JasonFJ9/BachelorThesisPCBs/README.md

# BachelorThesisPCBs
PCBs from Bachelor Thesis
