JasonFJ9/BachelorThesisPCBs/SolarEnergyManager_v1.0/SolarEnergyManager_v1.0_BOM.xlsx

Item | Qty | Reference(s) | Value | Footprint | Manufacturer_Part_Number | Mouser Part Number | Mouser Link
x | 0 | AH0, AH1, AH2 | JP | Jumper:SolderJumper-2_P1.3mm_Open_TrianglePad1.0x1.5mm
1 | 2 | C201, C202 | 15pF High Freq | Capacitor_SMD:C_0402_1005Metric | CBR04C150J5GACAUTO | 80-CBR04C150J5GAUTO | https://www.mouser.de/ProductDetail/KEMET/CBR04C150J5GACAUTO?qs=By6Nw2ByBD0gttAEYK%2FPlg%3D%3D
2 | 16 | C203, C204, C205, C206, C207, C208, C211, C212, C213, C215, C302, C304, C401, C403, C404, C406 | 0.1uF | Capacitor_SMD:C_0402_1005Metric | 0402X7R104KT7AT | 581-0402X7R104KT7AT | https://www.mouser.de/ProductDetail/KYOCERA-AVX/0402X7R104KT7AT?qs=DPoM0jnrROXD467pFR2ukA%3D%3D
3 | 6 | C209, C210, C501, C502, C503, C504 | 1uF | Capacitor_SMD:C_0402_1005Metric | MBASL105SB5105KFNA01 | 963-BASL105SB5105KF | https://www.mouser.de/ProductDetail/TAIYO-YUDEN/MBASL105SB5105KFNA01?qs=tlsG%2FOw5FFjuFnjILgo9OQ%3D%3D
4 | 3 | C214, C301, C303 | 4.7uF | Capacitor_SMD:C_0402_1005Metric | GRT155C81A475ME13D | 81-GRT155C81A475ME3D | https://www.mouser.de/ProductDetail/Murata-Electronics/GRT155C81A475ME13D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
5 | 2 | C402, C405 | 10uF | Capacitor_SMD:C_0402_1005Metric | GRT155R60J106ME13J | 81-GRT155R60J106ME13 | https://www.mouser.de/ProductDetail/Murata-Electronics/GRT155R60J106ME13J?qs=xZFQr2mActfRufp7i60hKA%3D%3D
x | 0 | C_Load1, J_RST1, J_RST2, P26, P30, PrbA1, PrbA2, PrbA3, PrbA_AEM1, PrbV1, PrbV2, PrbV3, PrbV_AEM1, R_Load1, USB_SRC1 | 01x02_Pin | Connector_PinHeader_2.54mm:PinHeader_1x02_P2.54mm_Vertical
6 | 2 | CBATT1, CLP5 | 220uF | Capacitor_SMD:C_1206_3216Metric | GRM31CR60J227ME11K | 81-GRM31CR60J227ME1K | https://www.mouser.de/ProductDetail/Murata-Electronics/GRM31CR60J227ME11K?qs=Ey7%2FXF42M3d4sLQcNXT7QA%3D%3D
7 | 1 | CBOOST1 | 22uF | Capacitor_SMD:C_0603_1608Metric | MSASJ168BB5226MTNA01 | 963-MSASJ168BB5226MT | https://www.mouser.de/ProductDetail/TAIYO-YUDEN/MSASJ168BB5226MTNA01?qs=tlsG%2FOw5FFg3tazonz3P5w%3D%3D
8 | 4 | CBUCK1, CHV1, CLV1, CSRC1 | 10uF | Capacitor_SMD:C_0603_1608Metric | MSASJ168AB5106KTNA01 | 963-MSASJ168AB5106KT | https://www.mouser.de/ProductDetail/TAIYO-YUDEN/MSASJ168AB5106KTNA01?qs=tlsG%2FOw5FFif5EhwKrunRA%3D%3D
9 | 1 | CLP0 | 1uF | Capacitor_SMD:C_1206_3216Metric | 12066C105KAT2A | 581-12066C105KAT2A | https://www.mouser.de/ProductDetail/KYOCERA-AVX/12066C105KAT2A?qs=gt1LBUVyoHm562E85hrgog%3D%3D
10 | 1 | CLP1 | 10uF | Capacitor_SMD:C_1206_3216Metric | 12066G106ZAT4A | 581-12066G106ZAT4A | https://www.mouser.de/ProductDetail/KYOCERA-AVX/12066G106ZAT4A?qs=f21FSZc47Pg9KHN6RDKhaQ%3D%3D
11 | 1 | CLP2 | 47uF | Capacitor_SMD:C_1206_3216Metric | JMK316ABJ476ML8T | 963-JMK316ABJ476ML8T | https://www.mouser.de/ProductDetail/TAIYO-YUDEN/JMK316ABJ476ML8T?qs=DPoM0jnrROULYJSu6x6JQQ%3D%3D
12 | 2 | CLP3, CLP4 | 100uF | Capacitor_SMD:C_1206_3216Metric | MSASJ31LAB5107MTNA01 | 963-MSASJ31LAB5107MT | https://www.mouser.de/ProductDetail/TAIYO-YUDEN/MSASJ31LAB5107MTNA01?qs=tlsG%2FOw5FFiNCooN9mmaqw%3D%3D
x | 0 | CLP4 | 150uF | Capacitor_SMD:C_1206_3216Metric | none | none
13 | 2 | D1, D501 | B5817W-TP | B5817W-TP:SOD3716X135N | B5817W-TP | 833-B5817W-TP | https://www.mouser.de/ProductDetail/Micro-Commercial-Components-MCC/B5817W-TP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
14 | 5 | D201, D202, D203, USB_LED1, VReg_LED1 | LED | LED_SMD:LED_0402_1005Metric | LB QH9G-N1OO-35-1 | 720-LBQH9G-N1P2-35-1 | https://www.mouser.de/ProductDetail/ams-OSRAM/LB-QH9G-N1OO-35-1?qs=74fRo9GAWsxCauYngFcKCA%3D%3D
x | 0 | H1, H2, H3, H4, Ha1, Ha2, Ha3, Ha4 | MountingHole_Pad | MountingHole:MountingHole_3.2mm_M3_Pad
15 | 1 | IC1 | AEM10941-QFN | AEM10941-QFN:QFN50P500X500X90-29N-D | AEM10941-QFN | 120-AEM10941-QFN | https://www.mouser.de/ProductDetail/e-peas/AEM10941-QFN?qs=W%2FMpXkg%252BdQ7CeqB2lBPbRQ%3D%3D
16 | 1 | IC201 | RP2040 | Package_DFN_QFN:QFN-56-1EP_7x7mm_P0.4mm_EP3.2x3.2mm | SC0914(13) | 358-SC091413 | https://www.mouser.de/ProductDetail/Raspberry-Pi/SC091413?qs=T%252BzbugeAwjhr%252BUbBr3TJcw%3D%3D
17 | 1 | IC202 | W25Q16JVUXIQ_TR | W25Q16JVUXIQ_TR:SON50P300X200X60-9N | W25Q16JVUXIQ TR | 454-W25Q16JVUXIQTR | https://www.mouser.de/ProductDetail/Winbond/W25Q16JVUXIQ-TR?qs=qSfuJ%252Bfl%2Fd7SDdIHLGOd1g%3D%3D
18 | 2 | IC301, IC302 | PAC1934T-I_JQ | PAC1934T-I_JQ:QFN65P400X400X55-17N-D | PAC1934T-I/JQ | 579-PAC1934JQ | https://www.mouser.de/ProductDetail/Microchip-Technology/PAC1934T-I-JQ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
19 | 1 | IC401 | VEML7700-TT | VEML7700-TT:VEML7700 | VEML7700-TT | 78-VEML7700-TT | https://www.mouser.de/ProductDetail/Vishay-Semiconductors/VEML7700-TT?qs=BcfjnG7NVaXdL6DJFdWbdw%3D%3D
20 | 1 | IC402 | TMP1075DSGR | TMP1075DSGR:SON50P200X200X80-9N | TMP1075DSGR | 595-TMP1075DSGR | https://www.mouser.de/ProductDetail/Texas-Instruments/TMP1075DSGR?qs=gZXFycFWdAOidBdJW42bRw%3D%3D
21 | 1 | IC403 | MCP23017-E_ML | MCP23017-E_ML:QFN65P600X600X100-29N-D | MCP23017-E/ML | 579-MCP23017-E/ML | https://www.mouser.de/ProductDetail/Microchip-Technology/MCP23017-E-ML?qs=usxtMOJb1RwOdfCNDE63wQ%3D%3D
22 | 2 | IC501, IC502 | AP2112K-3.3TRG1 | AP2112K-3.3TRG1:SOT95P282X130-5N | AP2112K-3.3TRG1 | 621-AP2112K-3.3TRG1 | https://www.mouser.de/ProductDetail/Diodes-Incorporated/AP2112K-3.3TRG1?qs=x6A8l6qLYDDPYHosCdzh%2FA%3D%3D
x | 0 | J201 | Conn_01x03_Pin | Connector_PinSocket_2.54mm:PinSocket_1x03_P2.54mm_Vertical
x | 0 | J202 | Conn_01x06_Pin | Connector_PinSocket_2.54mm:PinSocket_1x06_P2.54mm_Vertical
x | 0 | J203 | Conn_01x08_Pin | Connector_PinSocket_2.54mm:PinSocket_1x08_P2.54mm_Vertical
23 | 1 | J401 | MEM2052-00-195-00-A_REVA | MEM2052-00-195-00-A_REVA:GCT_MEM2052-00-195-00-A_REVA | MEM2052-00-195-00-A | 640-MEM20520019500A | https://www.mouser.de/ProductDetail/GCT/MEM2052-00-195-00-A?qs=Jm2GQyTW%2Fbh7Ze6LKWKWwA%3D%3D
24 | 1 | J501 | USB4105-GF-A | USB4105_GF_A:GCT_USB4105-GF-A | USB4105-GF-A | 640-USB4105-GF-A | https://www.mouser.de/ProductDetail/GCT/USB4105-GF-A?qs=KUoIvG%2F9IlY%2FMLlBMpStpA%3D%3D
x | 0 | J_AEM_OUT1, J_AEM_OUT2, LDO1, P_CFG0, P_CFG1, P_CFG2, P_ENHV1, P_ENLV1, P_SELMPP0, P_SELMPP1, VRegT1, VRegT2 | 01x03_Pin | Connector_PinHeader_2.54mm:PinHeader_1x03_P2.54mm_Vertical
x | 2 | J_BATT1, J_PRIM1 | S2B-PH-SM4-TB | S2B_PH_SM4_TB:CONN_S2B-PH-SM4-TB_JST
25 | 5 | J_BATT2, J_PRIM2, J_SC1, J_SC2, J_SRC1 | 691137710002 | 691137710002:CONN2_710002_WRE | 691137710002 | 710-691137710002 | https://www.mouser.de/ProductDetail/Wurth-Elektronik/691137710002?qs=lBTPRtX1sU9LnHBbviNKGA%3D%3D
26 | 1 | LBOOST1 | 10uH | Inductor_SMD:L_Vishay_IFSC-1515AH_4x4x1.8mm | LPS4018-103MRC | 994-LPS4018-103MRC | https://www.mouser.de/ProductDetail/Coilcraft/LPS4018-103MRC?qs=QQJxVsr8EGa4OX30WnhtBw%3D%3D
27 | 1 | LBUCK1 | 10uH | Inductor_SMD:L_0603_1608Metric | MLZ1608M100WTD25 | 810-MLZ1608M100WTD25 | https://www.mouser.de/ProductDetail/TDK/MLZ1608M100WTD25?qs=u4%252BEJ9urDATpNhOvJ54DAQ%3D%3D
28 | 3 | Q1, Q2, Q3 | BSS138 | BSS138:SOT95P240X120-3N | BSS138 | 512-BSS138 | https://www.mouser.de/ProductDetail/onsemi-Fairchild/BSS138?qs=HK%252BeIG1iaahCeqBvjB4arg%3D%3D
29 | 7 | Q6S12, Q601, Q602, Q603, Q604, Q605, Q606 | SI4204DY-T1-GE3 | SI4204DY-T1-GE3:SOIC127P600X175-8N | SI4204DY-T1-GE3 | 781-SI4204DY-T1-GE3 | https://www.mouser.de/ProductDetail/Vishay-Semiconductors/SI4204DY-T1-GE3?qs=WX95TUc1y56KMN7BzssOTA%3D%3D
x | 0 | R1, R4, R5, R6, R7, R8 | TBD | Resistor_SMD:R_0603_1608Metric
30 | 38 | R1L1, R1L2, R1L3, R1L4, R1L5, R1L6 R209, R210, R211, R212, R301, R302, R305, R306, R403, R404, R405, R406, R407, R408, R409, R503, R505, R607, R608, R609, R610, R611, R612, R619, R620, R621, R622, R623, R624 RsV1, RsV2, RsV3 | 10kR (35) nT; (3) 1% | Resistor_SMD:R_0402_1005Metric | RCC040210K0FKED | 71-RCC040210K0FKED | https://www.mouser.de/ProductDetail/Vishay-Dale/RCC040210K0FKED?qs=GedFDFLaBXEVoNpALwSuTw%3D%3D
31 | 6 | R2, R3, R25, R26, R29, R30 | 0R | Resistor_SMD:R_0603_1608Metric | RCC06030000Z0EA | 71-RCC06030000Z0EA | https://www.mouser.de/ProductDetail/Vishay-Dale/RCC06030000Z0EA?qs=GedFDFLaBXGafTcDIEa6hQ%3D%3D
32 | 2 | R27, R28 | 100R | Resistor_SMD:R_0603_1608Metric | SDR03EZPF1000 | 755-SDR03EZPF1000 | https://www.mouser.de/ProductDetail/ROHM-Semiconductor/SDR03EZPF1000?qs=byeeYqUIh0OpQ5v1HQWApg%3D%3D
33 | 2 | R201, R202 | 27R 1% HiP | Resistor_SMD:R_0402_1005Metric | CR0402-FX-27R0GLF | 652-CR0402FX-27R0GLF | https://www.mouser.de/ProductDetail/Bourns/CR0402-FX-27R0GLF?qs=SFHnMgm9IsxG%252BvpJZf0h2g%3D%3D
34 | 13 | R203, R601, R602, R603, R604, R605, R606, R613, R614, R615, R616, R617, R618 | 1kR | Resistor_SMD:R_0402_1005Metric | CRCW04021K00FKED | 71-CRCW0402-1.0K-E3 | https://www.mouser.de/ProductDetail/Vishay-Dale/CRCW04021K00FKED?qs=YX%252BK5oaHNYqQ2WK%252BIAW12A%3D%3D
35 | 5 | R204, R205, R206, R504, R506 | 1.5kR | Resistor_SMD:R_0402_1005Metric | CR0402-FX-1501GLF | 652-CR0402FX-1501GLF | https://www.mouser.de/ProductDetail/Bourns/CR0402-FX-1501GLF?qs=JflQ4L8so%2FsxQ5cqzjGcHQ%3D%3D
36 | 2 | R207, RA1 | 499R 1% | Resistor_SMD:R_0402_1005Metric | CR0402-FX-4990GLF | 652-CR0402FX-4990GLF | https://www.mouser.de/ProductDetail/Bourns/CR0402-FX-4990GLF?qs=ePR1ZvdkOKIzeZiWxp12Ig%3D%3D
37 | 1 | R208 | 2kR | Resistor_SMD:R_0402_1005Metric | 560112110064 | 710-560112110064 | https://www.mouser.de/ProductDetail/Wurth-Elektronik/560112110064?qs=mELouGlnn3ev5cD7nBIyFQ%3D%3D
38 | 3 | R213, R214, R402 | 4.7kR | Resistor_SMD:R_0402_1005Metric | 560112110245 | 710-560112110245 | https://www.mouser.de/ProductDetail/Wurth-Elektronik/560112110245?qs=mELouGlnn3eeBrSsGNQoSQ%3D%3D
39 | 5 | R303, R304, R307, R308, R401 | 0R | Resistor_SMD:R_0402_1005Metric | RCA04020000ZSED | 71-RCA04020000ZSED | https://www.mouser.de/ProductDetail/Vishay-Draloric/RCA04020000ZSED?qs=gk21WLQFtgRTmhk63km%2F1w%3D%3D
40 | 2 | R501, R502 | 5kR | Resistor_SMD:R_0402_1005Metric | RC0402FR-075KL | 603-RC0402FR-075KL | https://www.mouser.de/ProductDetail/YAGEO/RC0402FR-075KL?qs=9h0bZHM%2F3zL5adZvfm%252BR4Q%3D%3D
41 | 1 | RA2 | 806R 1% | Resistor_SMD:R_0402_1005Metric | CR0402-FX-8060GLF | 652-CR0402-FX8060GLF | https://www.mouser.de/ProductDetail/Bourns/CR0402-FX-8060GLF?qs=ePR1ZvdkOKKCsmL%252BFFkSoQ%3D%3D
42 | 1 | RLS0 | 1R 1% HiP | Resistor_SMD:R_0805_2012Metric | RCS08051R00FKEA | 71-RCS08051R00FKEA | https://www.mouser.de/ProductDetail/Vishay-Dale/RCS08051R00FKEA?qs=NKmfXavxMazIduhBo739WA%3D%3D
43 | 1 | RLS1 | 2.2R 1% HiP | Resistor_SMD:R_0805_2012Metric | CRCW08052R20FKEAHP | 71-CRCW08052R20FKEAH | https://www.mouser.de/ProductDetail/Vishay-Dale/CRCW08052R20FKEAHP?qs=40TFAHZMFvc8altFjF5kRw%3D%3D
44 | 1 | RLS2 | 4.7R 1% HiP | Resistor_SMD:R_0805_2012Metric | CRCW08054R70FKEAHP | 71-CRCW08054R70FKEAH | https://www.mouser.de/ProductDetail/Vishay-Dale/CRCW08054R70FKEAHP?qs=z98O12pCCDc%2FBP4iR2245Q%3D%3D
45 | 1 | RLS3 | 10R 1% HiP | Resistor_SMD:R_0805_2012Metric | CRCW080510R0FKEAHP | 71-CRCW080510R0FKEAH | https://www.mouser.de/ProductDetail/Vishay-Dale/CRCW080510R0FKEAHP?qs=k2%2FDWSARqgG82EOEfyX0fw%3D%3D
46 | 1 | RLS4 | 22R 1% HiP | Resistor_SMD:R_0805_2012Metric | RCS080522R0FKEA | 71-RCS080522R0FKEA | https://www.mouser.de/ProductDetail/Vishay-Dale/RCS080522R0FKEA?qs=HalnxurKHBtrICSsz48sGQ%3D%3D
47 | 1 | RLS5 | 33R 1% HiP | Resistor_SMD:R_0805_2012Metric | CRCW080533R0FKEAHP | 71-CRCW080533R0FKEAH | https://www.mouser.de/ProductDetail/Vishay-Dale/CRCW080533R0FKEAHP?qs=40TFAHZMFvf1kHsc18Wg6g%3D%3D
48 | 1 | RLS6 | 47R 1% HiP | Resistor_SMD:R_0805_2012Metric | CRCW080547R0FKEAHP | 71-CRCW080547R0FKEAH | https://www.mouser.de/ProductDetail/Vishay-Dale/CRCW080547R0FKEAHP?qs=YmE2lSBYOPn9tegEwszIow%3D%3D
49 | 5 | RsA1, RsA2, RsA3, RsA4, RsA5 | 0.5R 1% HiP | Resistor_SMD:R_0805_2012Metric | CSSH0805FTL500 | 708-CSSH0805FTL500 | https://www.mouser.de/ProductDetail/SEI-Stackpole/CSSH0805FTL500?qs=IPgv5n7u5QZm%252Br%252BnQCvBxw%3D%3D
50 | 3 | RVd1, RVd2, RVd3 | 150kR 1% | Resistor_SMD:R_0402_1005Metric | 560112110128 | 710-560112110128 | https://www.mouser.de/ProductDetail/Wurth-Elektronik/560112110128?qs=mELouGlnn3dmJAZZ6u3GOA%3D%3D
51 | 5 | S201, S202, S203, S204, S205 | TL3365AF180QG | TL3365AF180QG:TL3365AF180QG | TL3365AF180QG | 612-TL3365AF180QG | https://www.mouser.de/ProductDetail/E-Switch/TL3365AF180QG?qs=xQzBpF%2FAFTo%252BA4IL7l2Rvw%3D%3D
52 | 1 | SC1 | 47mF | Custom_Footprints_Lib:Capacitor_Radial_D12mm_P6.8mm | ADCM-S05R5SA473WB | 815-ADCMS05R5SA473WB | https://www.mouser.de/ProductDetail/ABRACON/ADCM-S05R5SA473WB?qs=HoCaDK9Nz5evZ626CffJaQ%3D%3D
x | 0 | SC_T_1 | Conn_02x02 | Connector_PinHeader_2.54mm:PinHeader_2x02_P2.54mm_Vertical
53 | 1 | Y201 | ABM8-272-T3 | ABM8-272-T3:ABM8272T3 | ABM8-272-T3 | 815-ABM8-272-T3 | https://www.mouser.de/ProductDetail/ABRACON/ABM8-272-T3?qs=QpmGXVUTftEj6miOiJBMxQ%3D%3D
