JasonFJ9/BachelorThesisPCBs/SolarCurveTracer_v1.1/SolarCurveTracer.kicad_pcb

## KiCad design SolarCurveTracer_v1.1/SolarCurveTracer.kicad_pcb (2024-07-26)

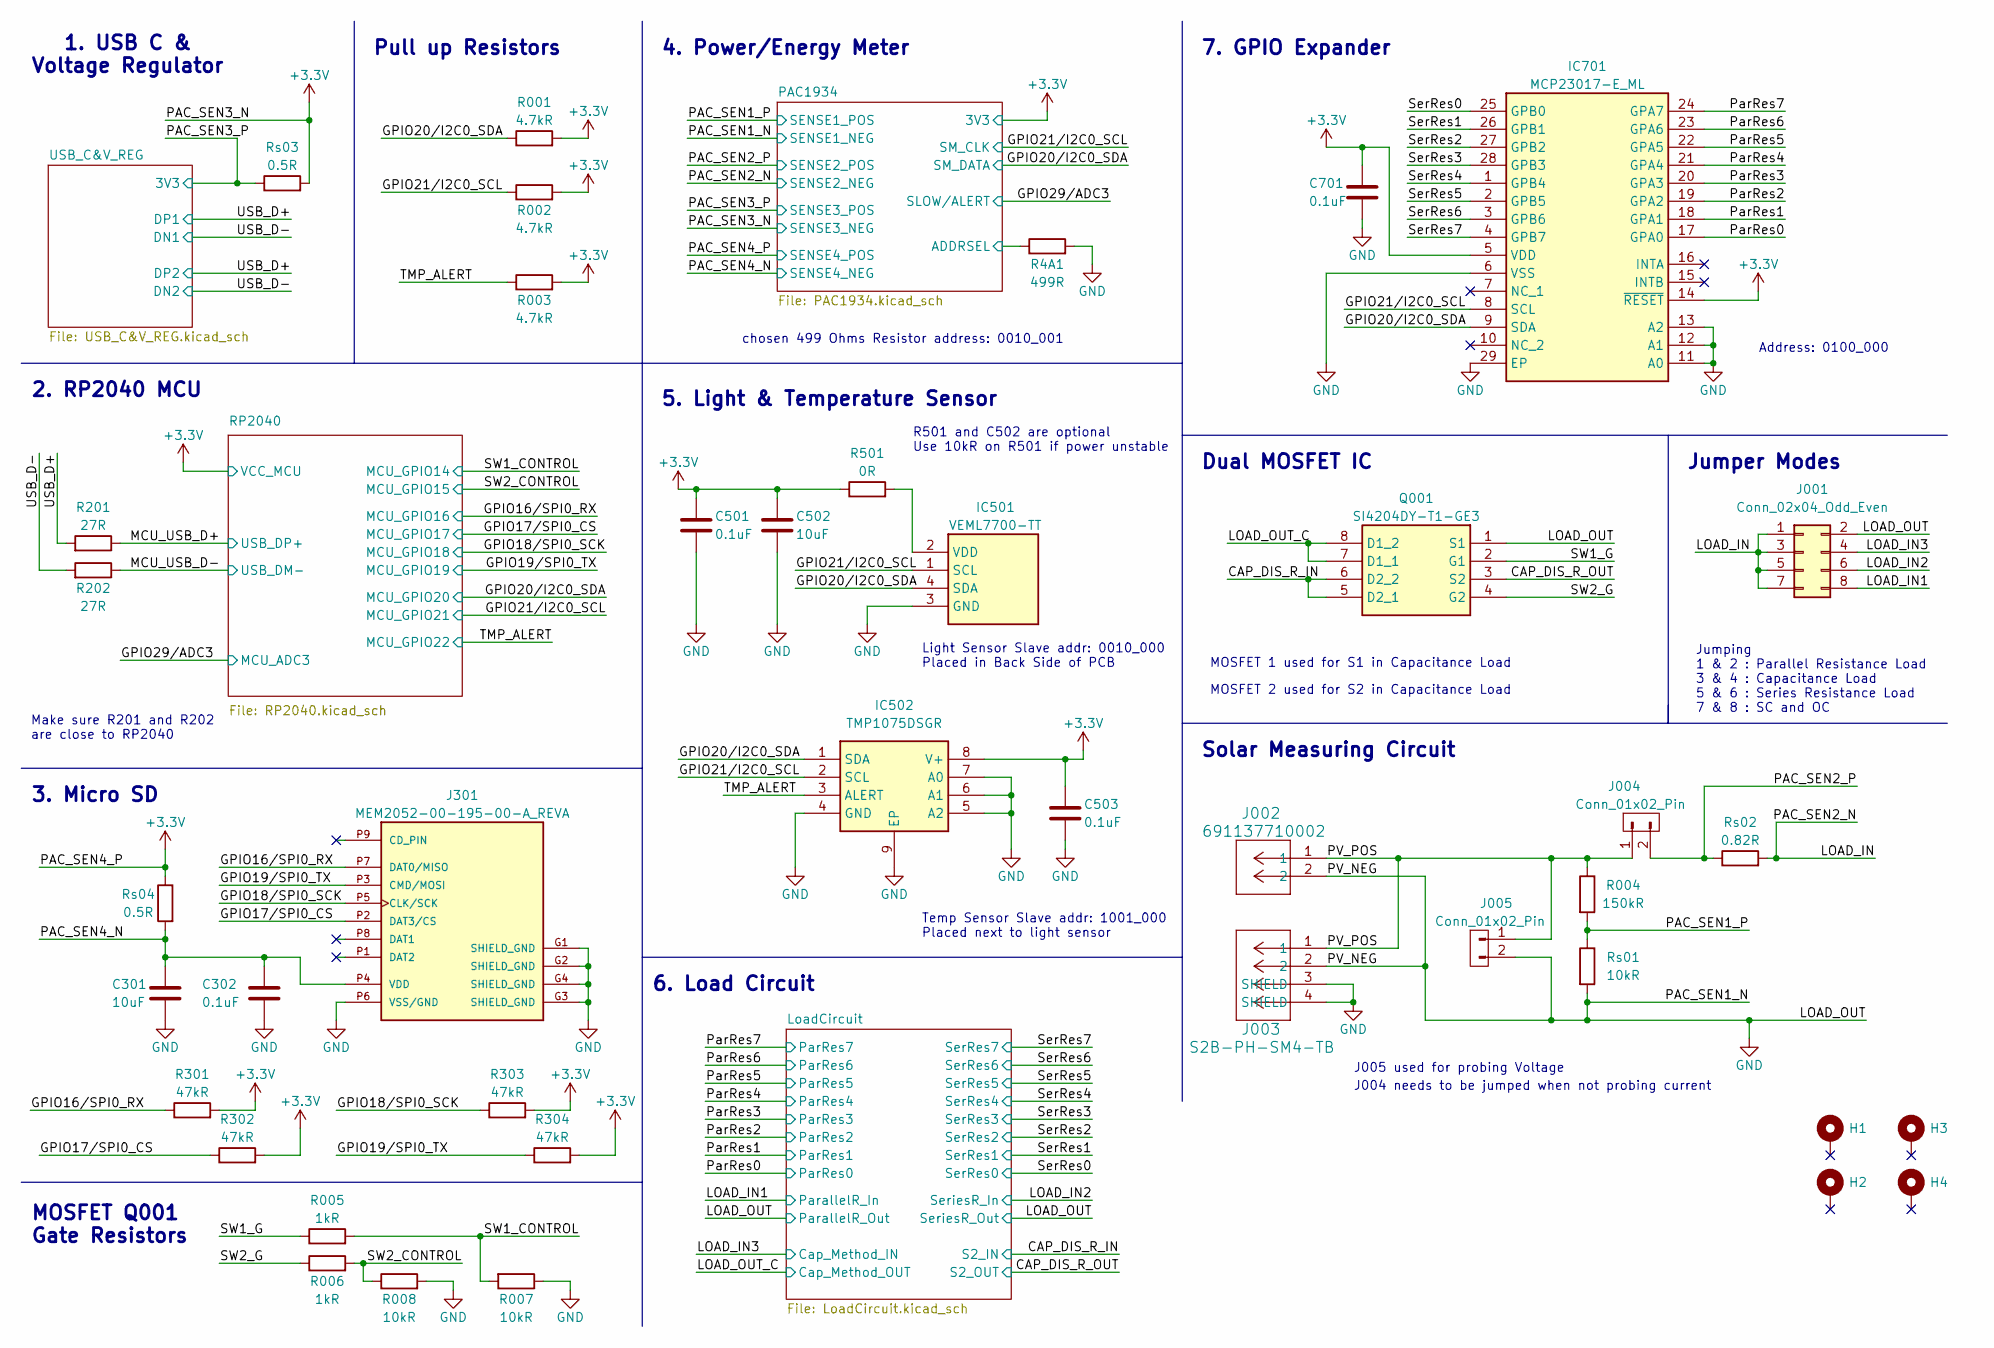
[picture p1: schematic SolarCurveTracer.kicad_sch, Solar Curve Tracer]

Parts:
C301, C502: 10uF; C_0603_1608Metric
C302, C501, C701: 0.1uF; C_0603_1608Metric
C503: 0.1uF; C_0402_1005Metric
H1, H2, H3, H4: MountingHole_Pad; MountingHole_3.2mm_M3_Pad
IC501: VEML7700-TT; VEML7700; Mouser Part Number 78-VEML7700-TT
IC502: TMP1075DSGR; SON50P200X200X80-9N; Mouser Part Number 595-TMP1075DSGR
IC701: MCP23017-E_ML; QFN65P600X600X100-29N-D; Mouser Part Number 579-MCP23017-E/ML
J001: Conn_02x04_Odd_Even; PinHeader_2x04_P2.54mm_Vertical
J002: 691137710002; CONN2_710002_WRE
J003: S2B-PH-SM4-TB; CONN_S2B-PH-SM4-TB_JST
J004, J005: Conn_01x02_Pin; PinHeader_1x02_P2.54mm_Vertical
J301: MEM2052-00-195-00-A_REVA; GCT_MEM2052-00-195-00-A_REVA; PARTREV A
Q001: SI4204DY-T1-GE3; SOIC127P600X175-8N; Mouser Part Number 781-SI4204DY-T1-GE3
R001, R002, R003: 4.7kR; R_0402_1005Metric
R004: 150kR; R_0603_1608Metric
R4A1: 499R; R_0603_1608Metric
R005, R006: 1kR; R_0402_1005Metric
R007, R008: 10kR; R_0402_1005Metric
R201, R202: 27R; R_0402_1005Metric
R301, R302, R303, R304: 47kR; R_0603_1608Metric
R501: 0R; R_0603_1608Metric
Rs01: 10kR; R_0805_2012Metric
Rs02: 0.82R; R_0805_2012Metric
Rs03, Rs04: 0.5R; R_0805_2012Metric

Connections:
+3.3V: C501.1, C502.1, C503.1, C701.1, IC502.8 (V+), IC701.5 (VDD), IC701.14 (~RESET), R001.2, R002.2, R003.2, R301.2, R302.2, R303.2, R304.2, R501.1, Rs03.2, Rs04.1; also elsewhere on the board
/CAP_DIS_R_IN: Q001.5 (D2_1), Q001.6 (D2_2); also elsewhere on the board
/CAP_DIS_R_OUT: Q001.3 (S2), Q001.7 (D1_1), Q001.8 (D1_2); also elsewhere on the board
/GPIO16/SPI0_RX: J301.P7 (DAT0/MISO), R301.1; also elsewhere on the board
/GPIO17/SPI0_CS: J301.P2 (DAT3/CS), R302.1; also elsewhere on the board
/GPIO18/SPI0_SCK: J301.P5 (CLK/SCK), R303.1; also elsewhere on the board
/GPIO19/SPI0_TX: J301.P3 (CMD/MOSI), R304.1; also elsewhere on the board
/GPIO20/I2C0_SDA: IC501.4 (SDA), IC502.1 (SDA), IC701.9 (SDA), R001.1; also elsewhere on the board
/GPIO21/I2C0_SCL: IC501.1 (SCL), IC502.2 (SCL), IC701.8 (SCL), R002.1; also elsewhere on the board
/LOAD_IN: J001.1, J001.3, J001.5, J001.7, Rs02.2; also elsewhere on the board
/LOAD_IN1: J001.8; also elsewhere on the board
/LOAD_IN2: J001.6; also elsewhere on the board
/LOAD_IN3: J001.4; also elsewhere on the board
/MCU_USB_D+: R201.1; also elsewhere on the board
/MCU_USB_D-: R202.1; also elsewhere on the board
/PAC1934/ADDRSEL: R4A1.1; also elsewhere on the board
/PAC_SEN1_P: R004.2, Rs01.1; also elsewhere on the board
/PAC_SEN2_P: J004.2, Rs02.1; also elsewhere on the board
/PAC_SEN3_P: Rs03.1; also elsewhere on the board
/PAC_SEN4_N: C301.1, C302.1, J301.P4 (VDD), Rs04.2; also elsewhere on the board
/PV_POS: J002.1, J003.1, J004.1, J005.1, R004.1
/ParRes0: IC701.17 (GPA0); also elsewhere on the board
/ParRes1: IC701.18 (GPA1); also elsewhere on the board
/ParRes2: IC701.19 (GPA2); also elsewhere on the board
/ParRes3: IC701.20 (GPA3); also elsewhere on the board
/ParRes4: IC701.21 (GPA4); also elsewhere on the board
/ParRes5: IC701.22 (GPA5); also elsewhere on the board
/ParRes6: IC701.23 (GPA6); also elsewhere on the board
/ParRes7: IC701.24 (GPA7); also elsewhere on the board
/SW1_CONTROL: R005.2, R007.2; also elsewhere on the board
/SW1_G: Q001.2 (G1), R005.1
/SW2_CONTROL: R006.2, R008.1; also elsewhere on the board
/SW2_G: Q001.4 (G2), R006.1
/SerRes0: IC701.25 (GPB0); also elsewhere on the board
/SerRes1: IC701.26 (GPB1); also elsewhere on the board
/SerRes2: IC701.27 (GPB2); also elsewhere on the board
/SerRes3: IC701.28 (GPB3); also elsewhere on the board
/SerRes4: IC701.1 (GPB4); also elsewhere on the board
/SerRes5: IC701.2 (GPB5); also elsewhere on the board
/SerRes6: IC701.3 (GPB6); also elsewhere on the board
/SerRes7: IC701.4 (GPB7); also elsewhere on the board
/TMP_ALERT: IC502.3 (ALERT), R003.1; also elsewhere on the board
/USB_D+: R201.2; also elsewhere on the board
/USB_D-: R202.2; also elsewhere on the board
GND: C301.2, C302.2, C501.2, C502.2, C503.2, C701.2, IC501.3 (GND), IC502.4 (GND), IC502.5 (A2), IC502.6 (A1), IC502.7 (A0), IC502.9 (EP), IC701.6 (VSS), IC701.11 (A0), IC701.12 (A1), IC701.13 (A2), IC701.29 (EP), J001.2, J002.2, J003.2, J003.3 (SHIELD), J003.4 (SHIELD), J005.2, J301.G1 (SHIELD_GND), J301.G2 (SHIELD_GND), J301.G3 (SHIELD_GND), J301.G4 (SHIELD_GND), J301.P6 (VSS/GND), Q001.1 (S1), R4A1.2, R007.1, R008.2, Rs01.2; also elsewhere on the board
unnamed: IC501.2 (VDD), R501.2

Notes on the sheet:
Jumper Modes
7. GPIO Expander
5. Light & Temperature Sensor
3. Micro SD
Solar Measuring Circuit
MOSFET 2 used for S2 in Capacitance Load
Dual MOSFET IC
Temp Sensor Slave addr: 1001_000 Placed next to light sensor
J005 used for probing Voltage
Make sure R201 and R202 are close to RP2040
Pull up Resistors
6. Load Circuit
R501 and C502 are optional Use 10kR on R501 if power unstable
1. USB C & Voltage Regulator
MOSFET Q001 Gate Resistors
2. RP2040 MCU
Light Sensor Slave addr: 0010_000 Placed in Back Side of PCB
MOSFET 1 used for S1 in Capacitance Load
chosen 499 Ohms Resistor address: 0010_001
J004 needs to be jumped when not probing current
Address: 0100_000
4. Power/Energy Meter
Jumping 1 & 2 : Parallel Resistance Load 3 & 4 : Capacitance Load 5 & 6 : Series Resistance Load 7 & 8 : SC and OC

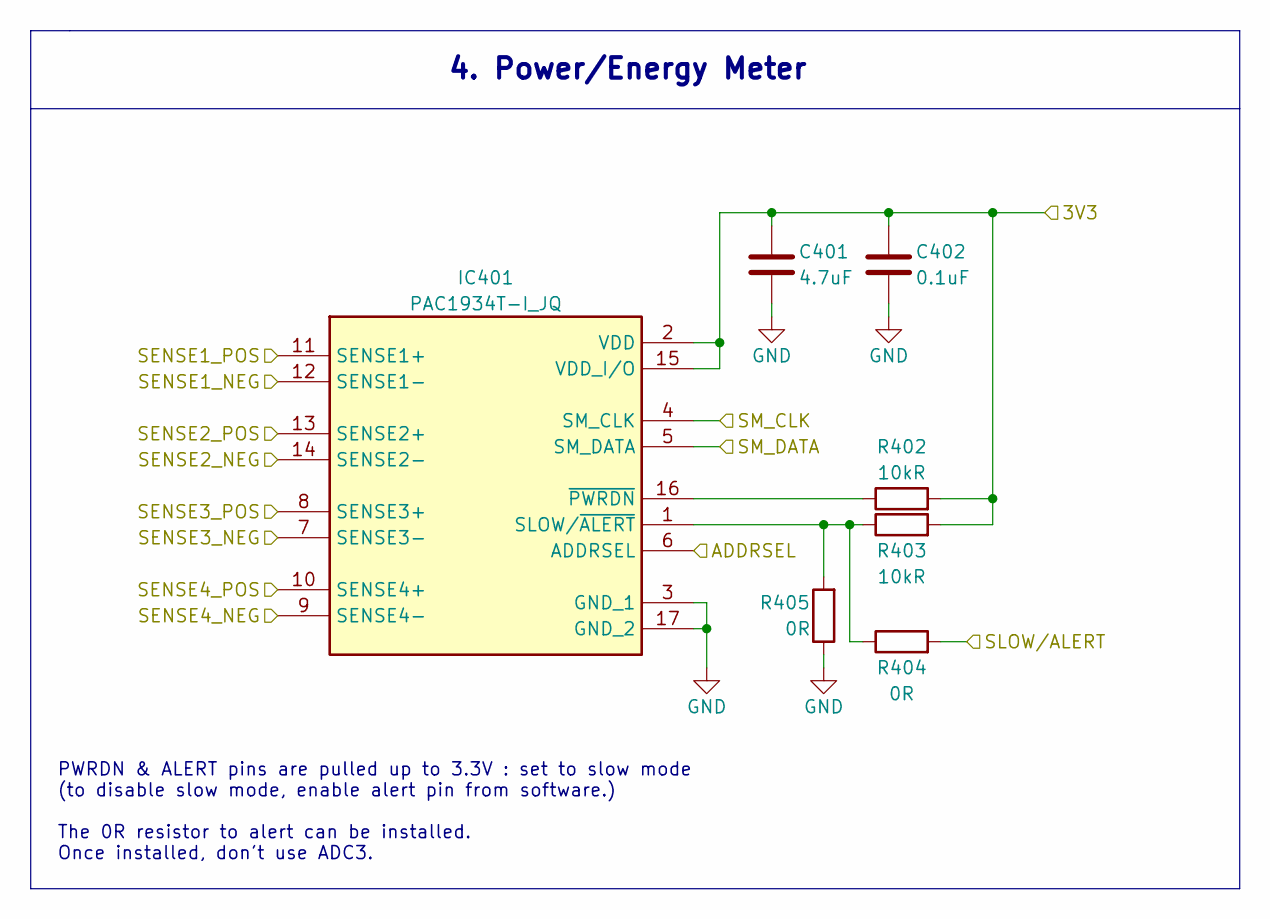
[picture p2: schematic PAC1934.kicad_sch, Solar Curve Tracer]

Parts:
C401: 4.7uF; C_0603_1608Metric
C402: 0.1uF; C_0603_1608Metric
IC401: PAC1934T-I_JQ; QFN65P400X400X55-17N-D; Mouser Part Number 579-PAC1934JQ
R402, R403: 10kR; R_0603_1608Metric
R404, R405: 0R; R_0603_1608Metric

Connections:
+3.3V: C401.1, C402.1, IC401.2 (VDD), IC401.7 (SENSE3-), IC401.10 (SENSE4+), IC401.15 (VDD_I/O), R402.2, R403.2; also elsewhere on the board
/GPIO20/I2C0_SDA: IC401.5 (SM_DATA); also elsewhere on the board
/GPIO21/I2C0_SCL: IC401.4 (SM_CLK); also elsewhere on the board
/GPIO29/ADC3: R404.2; also elsewhere on the board
/LOAD_IN: IC401.14 (SENSE2-); also elsewhere on the board
/PAC1934/ADDRSEL: IC401.6 (ADDRSEL); also elsewhere on the board
/PAC_SEN1_P: IC401.11 (SENSE1+); also elsewhere on the board
/PAC_SEN2_P: IC401.13 (SENSE2+); also elsewhere on the board
/PAC_SEN3_P: IC401.8 (SENSE3+); also elsewhere on the board
/PAC_SEN4_N: IC401.9 (SENSE4-); also elsewhere on the board
GND: C401.2, C402.2, IC401.3 (GND_1), IC401.12 (SENSE1-), IC401.17 (GND_2), R405.1; also elsewhere on the board
unnamed: IC401.1 (SLOW/~ALERT), R403.1, R404.1, R405.2
unnamed: IC401.16 (~PWRDN), R402.1

Notes on the sheet:
PWRDN & ALERT pins are pulled up to 3.3V : set to slow mode (to disable slow mode, enable alert pin from software.) The 0R resistor to alert can be installed. Once installed, don't use ADC3.
4. Power/Energy Meter

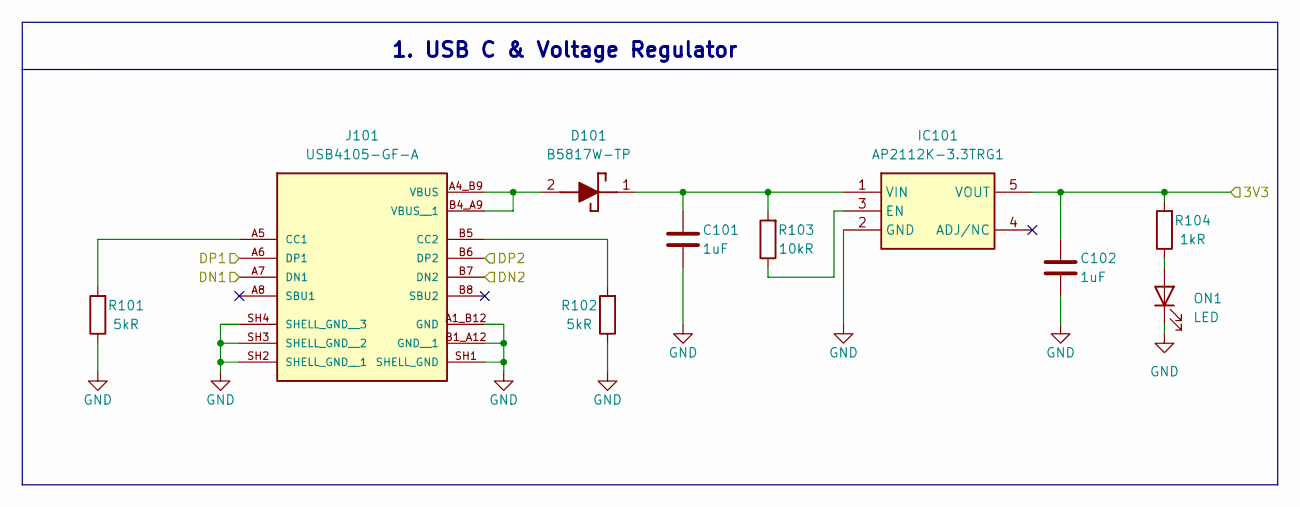
[picture p3: schematic USB_C&V_REG.kicad_sch, Solar Curve Tracer]

Parts:
C101, C102: 1uF; C_0603_1608Metric
D101: B5817W-TP; SOD3716X135N; Mouser Part Number 833-B5817W-TP
IC101: AP2112K-3.3TRG1; SOT95P282X130-5N; Mouser Part Number 621-AP2112K-3.3TRG1
J101: USB4105-GF-A; GCT_USB4105-GF-A; PARTREV B3
ON1: LED; LED_0603_1608Metric
R101, R102: 5kR; R_0603_1608Metric
R103: 10kR; R_0603_1608Metric
R104: 1kR; R_0603_1608Metric

Connections:
/PAC_SEN3_P: C102.1, IC101.5 (VOUT), R104.2; also elsewhere on the board
/USB_D+: J101.A6 (DP1), J101.B6 (DP2); also elsewhere on the board
/USB_D-: J101.A7 (DN1), J101.B7 (DN2); also elsewhere on the board
GND: C101.2, C102.2, IC101.2 (GND), J101.A1_B12 (GND), J101.B1_A12 (GND__1), J101.SH1 (SHELL_GND), J101.SH2 (SHELL_GND__1), J101.SH3 (SHELL_GND__2), J101.SH4 (SHELL_GND__3), ON1.1 (K), R101.1, R102.1; also elsewhere on the board
unnamed: D101.2 (A), J101.A4_B9 (VBUS), J101.B4_A9 (VBUS__1)
unnamed: C101.1, D101.1 (K), IC101.1 (VIN), R103.2
unnamed: IC101.3 (EN), R103.1
unnamed: J101.A5 (CC1), R101.2
unnamed: J101.B5 (CC2), R102.2
unnamed: ON1.2 (A), R104.1

Notes on the sheet:
1. USB C & Voltage Regulator

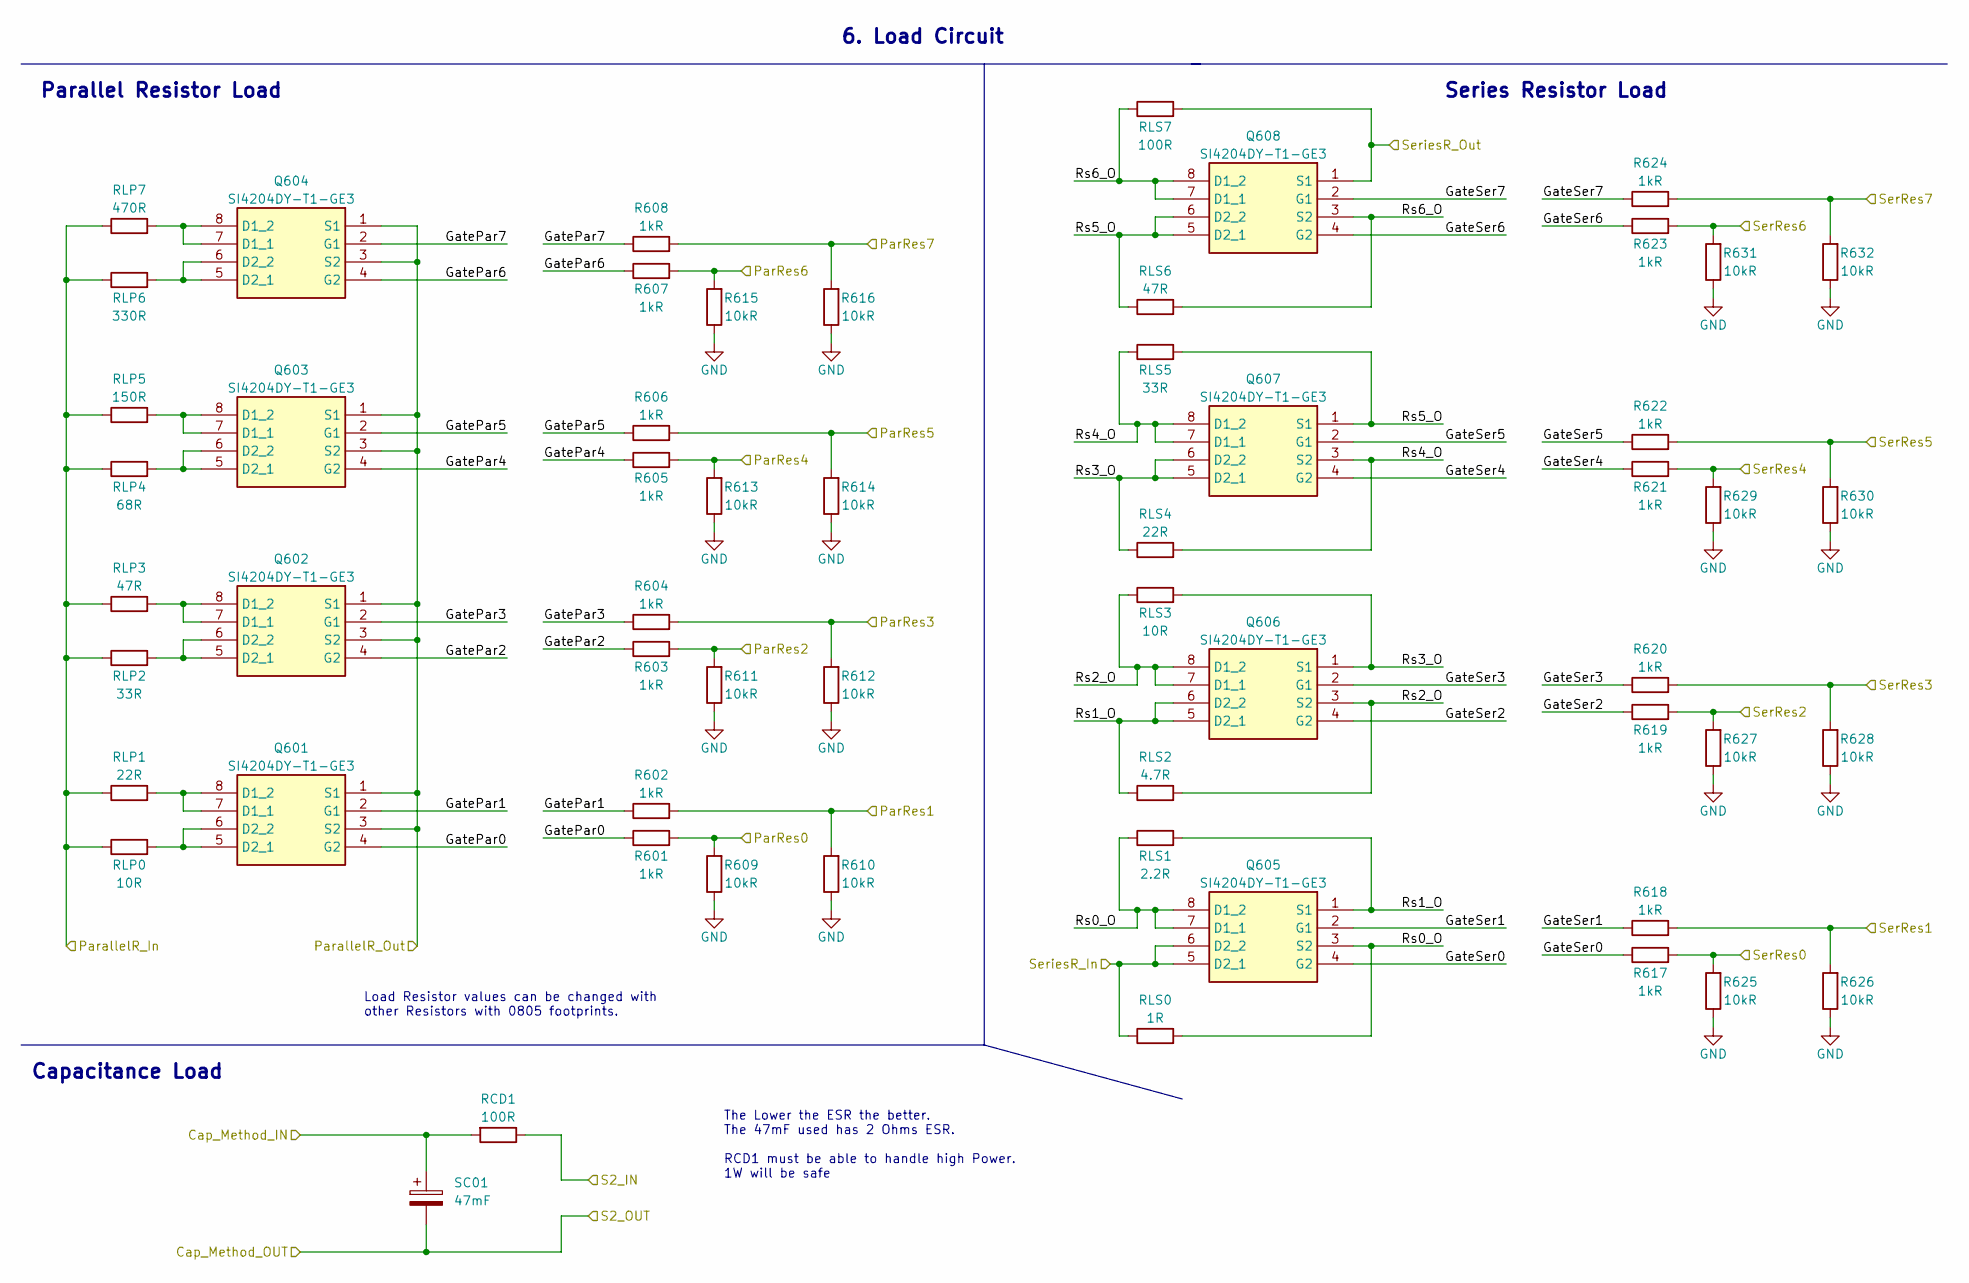
[picture p4: schematic LoadCircuit.kicad_sch, Solar Curve Tracer]

Parts:
Q601, Q602, Q603, Q604, Q605, Q606, Q607, Q608: SI4204DY-T1-GE3; SOIC127P600X175-8N; Mouser Part Number 781-SI4204DY-T1-GE3
R601, R602, R603, R604, R605, R606, R607, R608, R617, R618, R619, R620, R621, R622, R623, R624: 1kR; R_0402_1005Metric
R609, R610, R611, R612, R613, R614, R615, R616, R625, R626, R627, R628, R629, R630, R631, R632: 10kR; R_0402_1005Metric
RCD1: 100R; R_0805_2012Metric
RLP0: 10R; R_0805_2012Metric
RLP1: 22R; R_0805_2012Metric
RLP2: 33R; R_0805_2012Metric
RLP3: 47R; R_0805_2012Metric
RLP4: 68R; R_0805_2012Metric
RLP5: 150R; R_0805_2012Metric
RLP6: 330R; R_0805_2012Metric
RLP7: 470R; R_0805_2012Metric
RLS0: 1R; R_0805_2012Metric
RLS1: 2.2R; R_0805_2012Metric
RLS2: 4.7R; R_0805_2012Metric
RLS3: 10R; R_0805_2012Metric
RLS4: 22R; R_0805_2012Metric
RLS5: 33R; R_0805_2012Metric
RLS6: 47R; R_0805_2012Metric
RLS7: 100R; R_0805_2012Metric
SC01: 47mF; Capacitor_Radial_D12mm_P6.8mm

Connections:
/CAP_DIS_R_IN: RCD1.1; also elsewhere on the board
/CAP_DIS_R_OUT: SC01.2; also elsewhere on the board
/LOAD_IN1: RLP0.1, RLP1.1, RLP2.1, RLP3.1, RLP4.1, RLP5.1, RLP6.1, RLP7.1; also elsewhere on the board
/LOAD_IN2: Q605.5 (D2_1), Q605.6 (D2_2), RLS0.1; also elsewhere on the board
/LOAD_IN3: RCD1.2, SC01.1; also elsewhere on the board
/LoadCircuit/GatePar0: Q601.4 (G2), R601.1
/LoadCircuit/GatePar1: Q601.2 (G1), R602.1
/LoadCircuit/GatePar2: Q602.4 (G2), R603.1
/LoadCircuit/GatePar3: Q602.2 (G1), R604.1
/LoadCircuit/GatePar4: Q603.4 (G2), R605.1
/LoadCircuit/GatePar5: Q603.2 (G1), R606.1
/LoadCircuit/GatePar6: Q604.4 (G2), R607.1
/LoadCircuit/GatePar7: Q604.2 (G1), R608.1
/LoadCircuit/GateSer0: Q605.4 (G2), R617.1
/LoadCircuit/GateSer1: Q605.2 (G1), R618.1
/LoadCircuit/GateSer2: Q606.4 (G2), R619.1
/LoadCircuit/GateSer3: Q606.2 (G1), R620.1
/LoadCircuit/GateSer4: Q607.4 (G2), R621.1
/LoadCircuit/GateSer5: Q607.2 (G1), R622.1
/LoadCircuit/GateSer6: Q608.4 (G2), R623.1
/LoadCircuit/GateSer7: Q608.2 (G1), R624.1
/LoadCircuit/Rs0_O: Q605.3 (S2), Q605.7 (D1_1), Q605.8 (D1_2), RLS0.2, RLS1.1
/LoadCircuit/Rs1_O: Q605.1 (S1), Q606.5 (D2_1), Q606.6 (D2_2), RLS1.2, RLS2.1
/LoadCircuit/Rs2_O: Q606.3 (S2), Q606.7 (D1_1), Q606.8 (D1_2), RLS2.2, RLS3.1
/LoadCircuit/Rs3_O: Q606.1 (S1), Q607.5 (D2_1), Q607.6 (D2_2), RLS3.2, RLS4.1
/LoadCircuit/Rs4_O: Q607.3 (S2), Q607.7 (D1_1), Q607.8 (D1_2), RLS4.2, RLS5.1
/LoadCircuit/Rs5_O: Q607.1 (S1), Q608.5 (D2_1), Q608.6 (D2_2), RLS5.2, RLS6.1
/LoadCircuit/Rs6_O: Q608.3 (S2), Q608.7 (D1_1), Q608.8 (D1_2), RLS6.2, RLS7.1
/ParRes0: R601.2, R609.2; also elsewhere on the board
/ParRes1: R602.2, R610.2; also elsewhere on the board
/ParRes2: R603.2, R611.2; also elsewhere on the board
/ParRes3: R604.2, R612.2; also elsewhere on the board
/ParRes4: R605.2, R613.2; also elsewhere on the board
/ParRes5: R606.2, R614.2; also elsewhere on the board
/ParRes6: R607.2, R615.2; also elsewhere on the board
/ParRes7: R608.2, R616.2; also elsewhere on the board
/SerRes0: R617.2, R625.2; also elsewhere on the board
/SerRes1: R618.2, R626.2; also elsewhere on the board
/SerRes2: R619.2, R627.2; also elsewhere on the board
/SerRes3: R620.2, R628.2; also elsewhere on the board
/SerRes4: R621.2, R629.2; also elsewhere on the board
/SerRes5: R622.2, R630.2; also elsewhere on the board
/SerRes6: R623.2, R631.2; also elsewhere on the board
/SerRes7: R624.2, R632.2; also elsewhere on the board
GND: Q601.1 (S1), Q601.3 (S2), Q602.1 (S1), Q602.3 (S2), Q603.1 (S1), Q603.3 (S2), Q604.1 (S1), Q604.3 (S2), Q608.1 (S1), R609.1, R610.1, R611.1, R612.1, R613.1, R614.1, R615.1, R616.1, R625.1, R626.1, R627.1, R628.1, R629.1, R630.1, R631.1, R632.1, RLS7.2; also elsewhere on the board
unnamed: Q601.7 (D1_1), Q601.8 (D1_2), RLP1.2
unnamed: Q601.5 (D2_1), Q601.6 (D2_2), RLP0.2
unnamed: Q602.7 (D1_1), Q602.8 (D1_2), RLP3.2
unnamed: Q602.5 (D2_1), Q602.6 (D2_2), RLP2.2
unnamed: Q603.7 (D1_1), Q603.8 (D1_2), RLP5.2
unnamed: Q603.5 (D2_1), Q603.6 (D2_2), RLP4.2
unnamed: Q604.7 (D1_1), Q604.8 (D1_2), RLP7.2
unnamed: Q604.5 (D2_1), Q604.6 (D2_2), RLP6.2

Notes on the sheet:
Parallel Resistor Load
The Lower the ESR the better. The 47mF used has 2 Ohms ESR. RCD1 must be able to handle high Power. 1W will be safe
6. Load Circuit
Load Resistor values can be changed with other Resistors with 0805 footprints.
Series Resistor Load
Capacitance Load

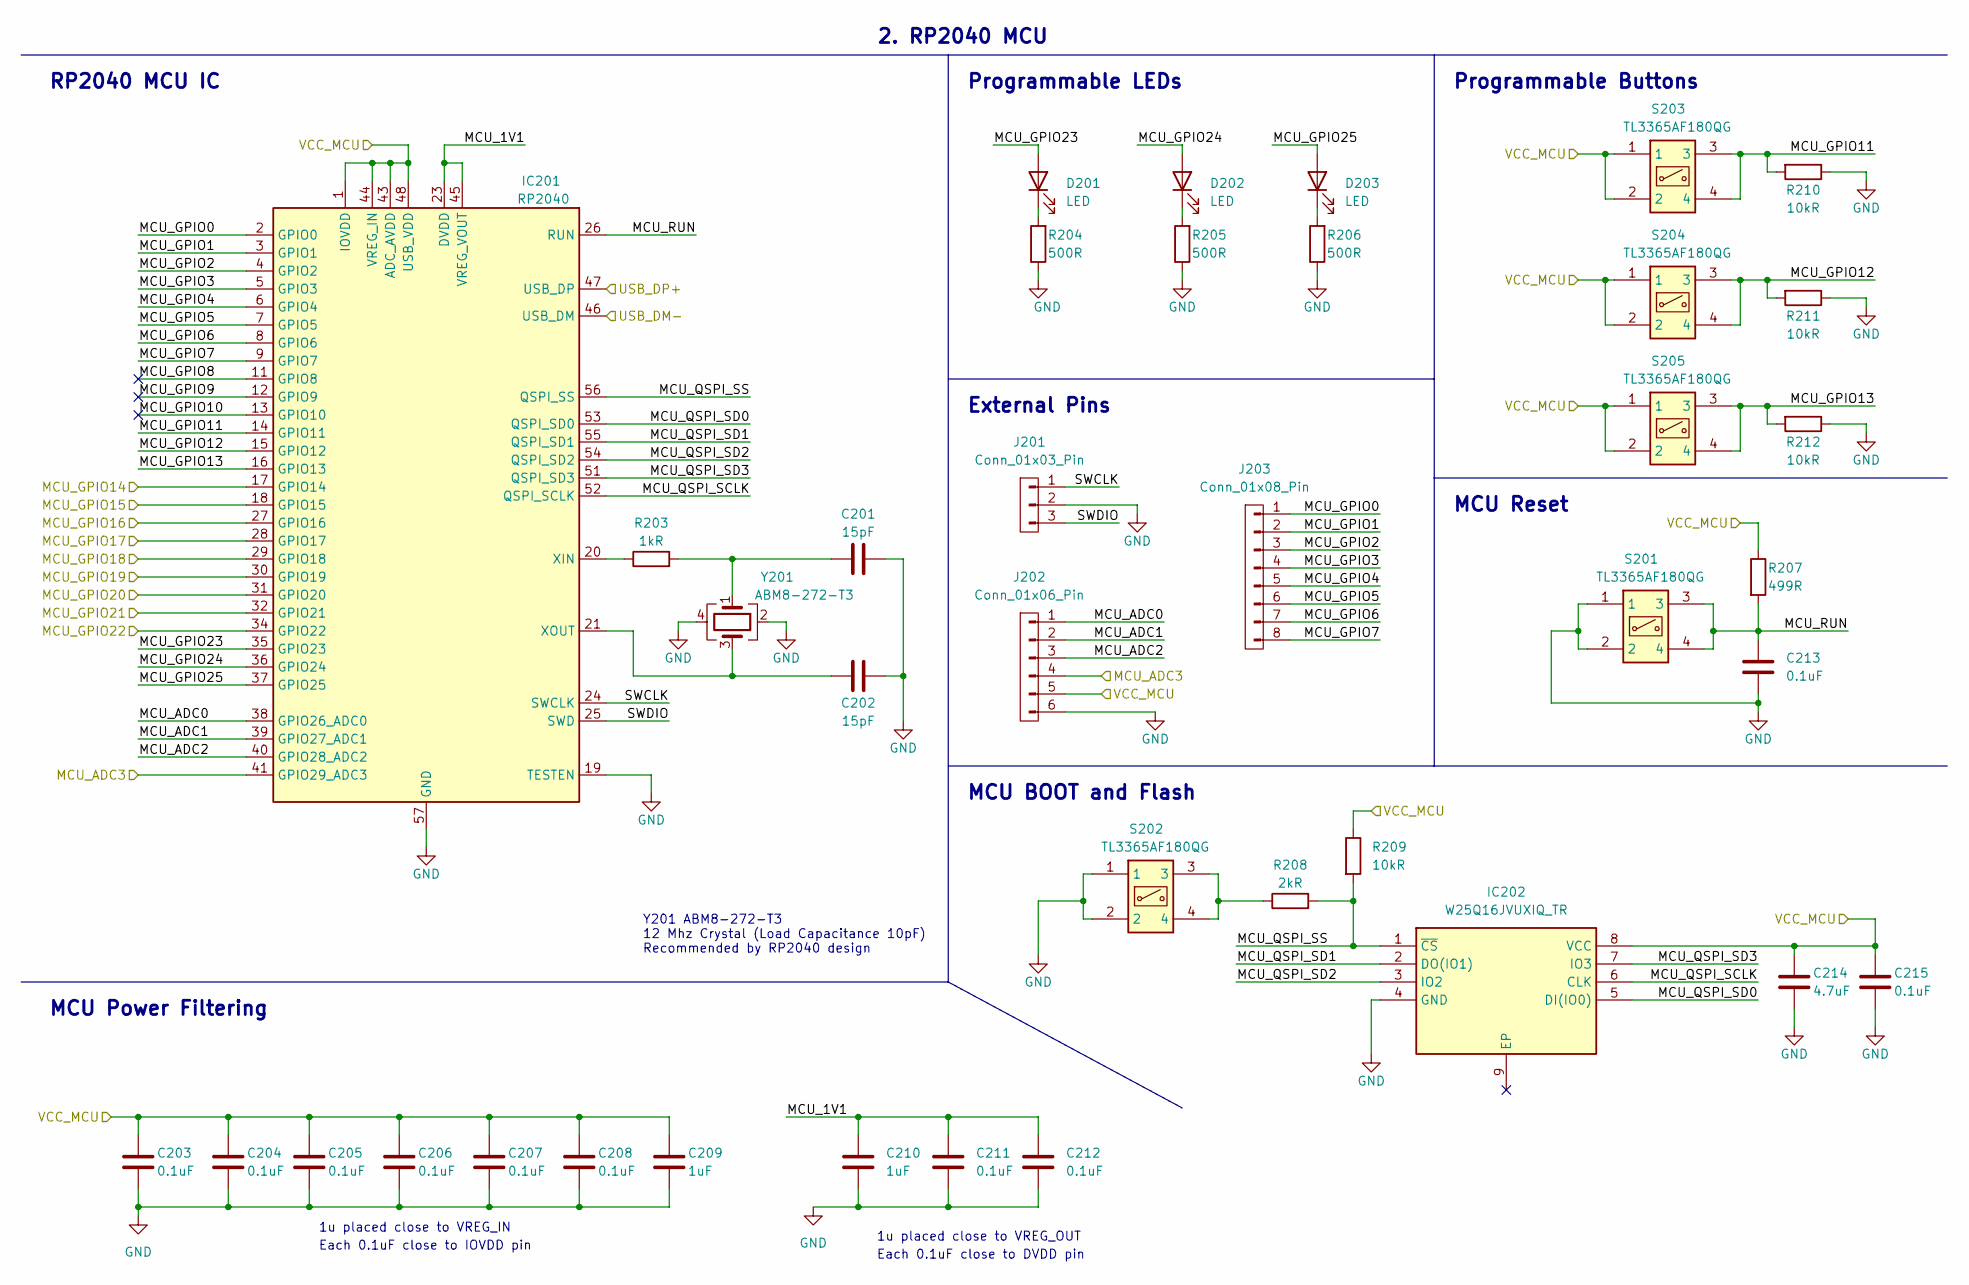
[picture p5: schematic RP2040.kicad_sch, Solar Curve Tracer]

Parts:
C201, C202: 15pF; C_0402_1005Metric
C203, C204, C205, C206, C207, C208, C211, C212, C213, C215: 0.1uF; C_0402_1005Metric
C209, C210: 1uF; C_0402_1005Metric
C214: 4.7uF; C_0402_1005Metric
D201, D202, D203: LED; LED_0402_1005Metric
IC201: RP2040; QFN-56-1EP_7x7mm_P0.4mm_EP3.2x3.2mm
IC202: W25Q16JVUXIQ_TR; SON50P300X200X60-9N; Mouser Part Number 454-W25Q16JVUXIQTR
J201: Conn_01x03_Pin; PinSocket_1x03_P2.54mm_Vertical
J202: Conn_01x06_Pin; PinSocket_1x06_P2.54mm_Vertical
J203: Conn_01x08_Pin; PinSocket_1x08_P2.54mm_Vertical
R203: 1kR; R_0402_1005Metric
R204, R205, R206: 500R; R_0402_1005Metric
R207: 499R; R_0402_1005Metric
R208: 2kR; R_0402_1005Metric
R209, R210, R211, R212: 10kR; R_0402_1005Metric
S201, S202, S203, S204, S205: TL3365AF180QG; Mouser Part Number 612-TL3365AF180QG
Y201: ABM8-272-T3; ABM8272T3

Connections:
+3.3V: C203.1, C204.1, C205.1, C206.1, C207.1, C208.1, C209.1, C214.1, C215.1, IC201.1 (IOVDD), IC201.10 (IOVDD), IC201.22 (IOVDD), IC201.33 (IOVDD), IC201.42 (IOVDD), IC201.43 (ADC_AVDD), IC201.44 (VREG_IN), IC201.48 (USB_VDD), IC201.49 (IOVDD), IC202.8 (VCC), J202.5, R207.1, R209.1, S203.1, S203.2, S204.1, S204.2, S205.1, S205.2; also elsewhere on the board
/GPIO16/SPI0_RX: IC201.27 (GPIO16); also elsewhere on the board
/GPIO17/SPI0_CS: IC201.28 (GPIO17); also elsewhere on the board
/GPIO18/SPI0_SCK: IC201.29 (GPIO18); also elsewhere on the board
/GPIO19/SPI0_TX: IC201.30 (GPIO19); also elsewhere on the board
/GPIO20/I2C0_SDA: IC201.31 (GPIO20); also elsewhere on the board
/GPIO21/I2C0_SCL: IC201.32 (GPIO21); also elsewhere on the board
/GPIO29/ADC3: IC201.41 (GPIO29_ADC3), J202.4; also elsewhere on the board
/MCU_USB_D+: IC201.47 (USB_DP); also elsewhere on the board
/MCU_USB_D-: IC201.46 (USB_DM); also elsewhere on the board
/RP2040/MCU_1V1: C210.1, C211.1, C212.1, IC201.23 (DVDD), IC201.45 (VREG_VOUT), IC201.50 (DVDD)
/RP2040/MCU_ADC0: IC201.38 (GPIO26_ADC0), J202.1
/RP2040/MCU_ADC1: IC201.39 (GPIO27_ADC1), J202.2
/RP2040/MCU_ADC2: IC201.40 (GPIO28_ADC2), J202.3
/RP2040/MCU_GPIO0: IC201.2 (GPIO0), J203.1
/RP2040/MCU_GPIO1: IC201.3 (GPIO1), J203.2
/RP2040/MCU_GPIO2: IC201.4 (GPIO2), J203.3
/RP2040/MCU_GPIO3: IC201.5 (GPIO3), J203.4
/RP2040/MCU_GPIO4: IC201.6 (GPIO4), J203.5
/RP2040/MCU_GPIO5: IC201.7 (GPIO5), J203.6
/RP2040/MCU_GPIO6: IC201.8 (GPIO6), J203.7
/RP2040/MCU_GPIO7: IC201.9 (GPIO7), J203.8
/RP2040/MCU_GPIO8: IC201.11 (GPIO8)
/RP2040/MCU_GPIO9: IC201.12 (GPIO9)
/RP2040/MCU_GPIO10: IC201.13 (GPIO10)
/RP2040/MCU_GPIO11: IC201.14 (GPIO11), R210.2, S203.3, S203.4
/RP2040/MCU_GPIO12: IC201.15 (GPIO12), R211.2, S204.3, S204.4
/RP2040/MCU_GPIO13: IC201.16 (GPIO13), R212.2, S205.3, S205.4
/RP2040/MCU_GPIO23: D201.2 (A), IC201.35 (GPIO23)
/RP2040/MCU_GPIO24: D202.2 (A), IC201.36 (GPIO24)
/RP2040/MCU_GPIO25: D203.2 (A), IC201.37 (GPIO25)
/RP2040/MCU_QSPI_SCLK: IC201.52 (QSPI_SCLK), IC202.6 (CLK)
/RP2040/MCU_QSPI_SD0: IC201.53 (QSPI_SD0), IC202.5 (DI(IO0))
/RP2040/MCU_QSPI_SD1: IC201.55 (QSPI_SD1), IC202.2 (DO(IO1))
/RP2040/MCU_QSPI_SD2: IC201.54 (QSPI_SD2), IC202.3 (IO2)
/RP2040/MCU_QSPI_SD3: IC201.51 (QSPI_SD3), IC202.7 (IO3)
/RP2040/MCU_QSPI_SS: IC201.56 (QSPI_SS), IC202.1 (~CS), R208.2, R209.2
/RP2040/MCU_RUN: C213.1, IC201.26 (RUN), R207.2, S201.3, S201.4
/RP2040/SWCLK: IC201.24 (SWCLK), J201.1
/RP2040/SWDIO: IC201.25 (SWD), J201.3
/SW1_CONTROL: IC201.17 (GPIO14); also elsewhere on the board
/SW2_CONTROL: IC201.18 (GPIO15); also elsewhere on the board
/TMP_ALERT: IC201.34 (GPIO22); also elsewhere on the board
GND: C201.2, C202.2, C203.2, C204.2, C205.2, C206.2, C207.2, C208.2, C209.2, C210.2, C211.2, C212.2, C213.2, C214.2, C215.2, IC201.19 (TESTEN), IC201.57 (GND), IC202.4 (GND), J201.2, J202.6, R204.1, R205.1, R206.1, R210.1, R211.1, R212.1, S201.1, S201.2, S202.1, S202.2, Y201.2, Y201.4; also elsewhere on the board
unnamed: C201.1, R203.2, Y201.1
unnamed: D201.1 (K), R204.2
unnamed: D202.1 (K), R205.2
unnamed: D203.1 (K), R206.2
unnamed: IC201.20 (XIN), R203.1
unnamed: C202.1, IC201.21 (XOUT), Y201.3
unnamed: R208.1, S202.3, S202.4

Notes on the sheet:
1u placed close to VREG_IN
1u placed close to VREG_OUT
Each 0.1uF close to IOVDD pin
RP2040 MCU IC
MCU BOOT and Flash
MCU Power Filtering
Programmable Buttons
MCU Reset
Y201 ABM8-272-T3 12 Mhz Crystal (Load Capacitance 10pF) Recommended by RP2040 design
2. RP2040 MCU
Programmable LEDs
External Pins
Each 0.1uF close to DVDD pin

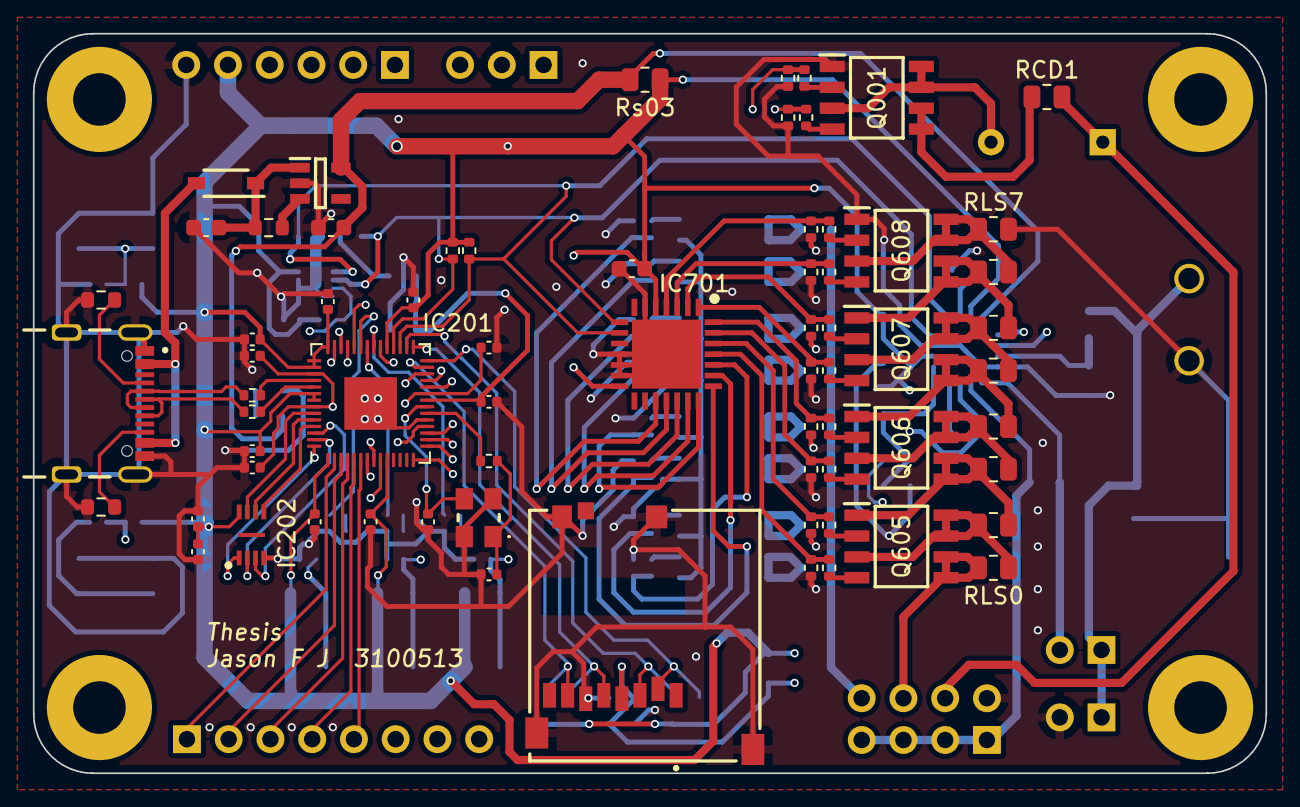
[picture p6: board SolarCurveTracer.kicad_pcb from above]

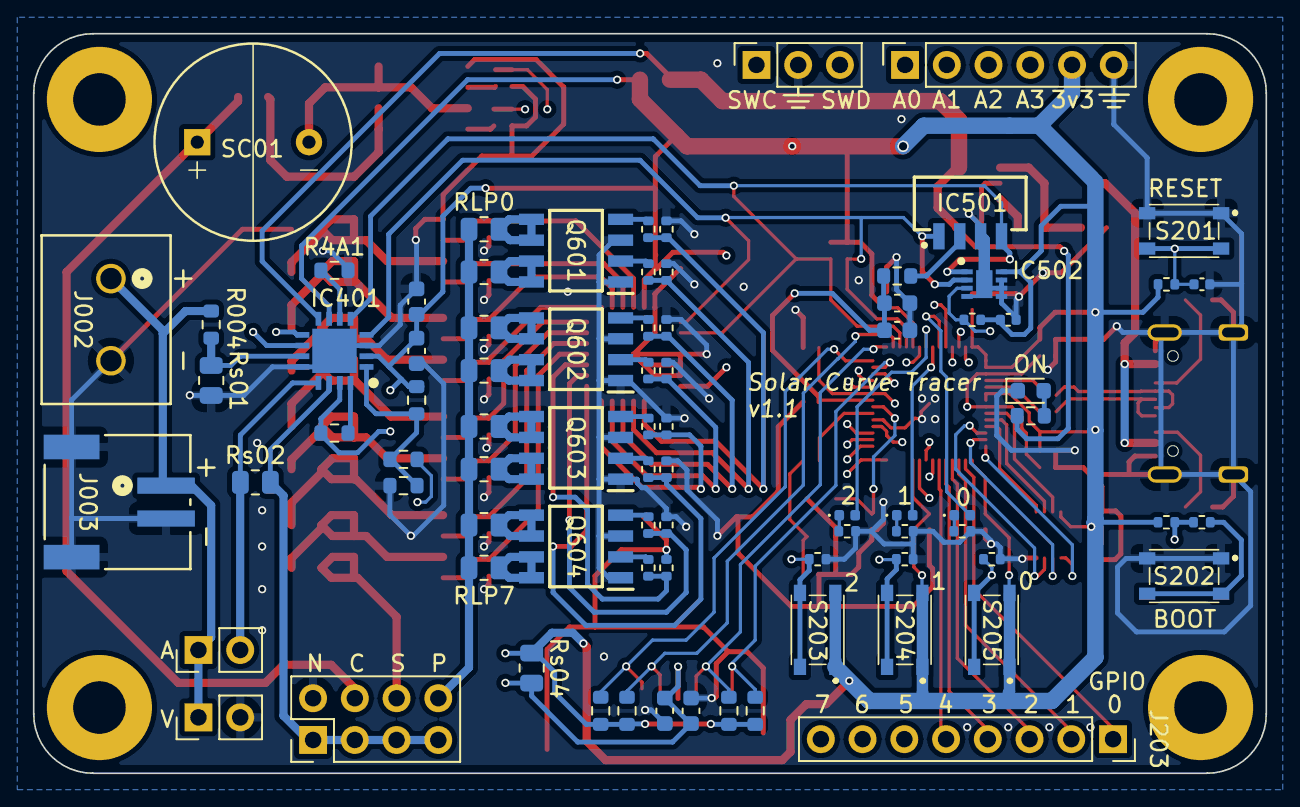
[picture p7: board SolarCurveTracer.kicad_pcb from below]

Board: 4 copper layers, 75.0 x 45.0 mm, 154 parts (82 on the bottom side), 120 nets.
