JasonFJ9/BachelorThesisPCBs/SolarEnergyManager_v1.0/SolarEnergyManager_v1.0.kicad_pcb

## KiCad design SolarEnergyManager_v1.0/SolarEnergyManager_v1.0.kicad_pcb (2024-07-26)

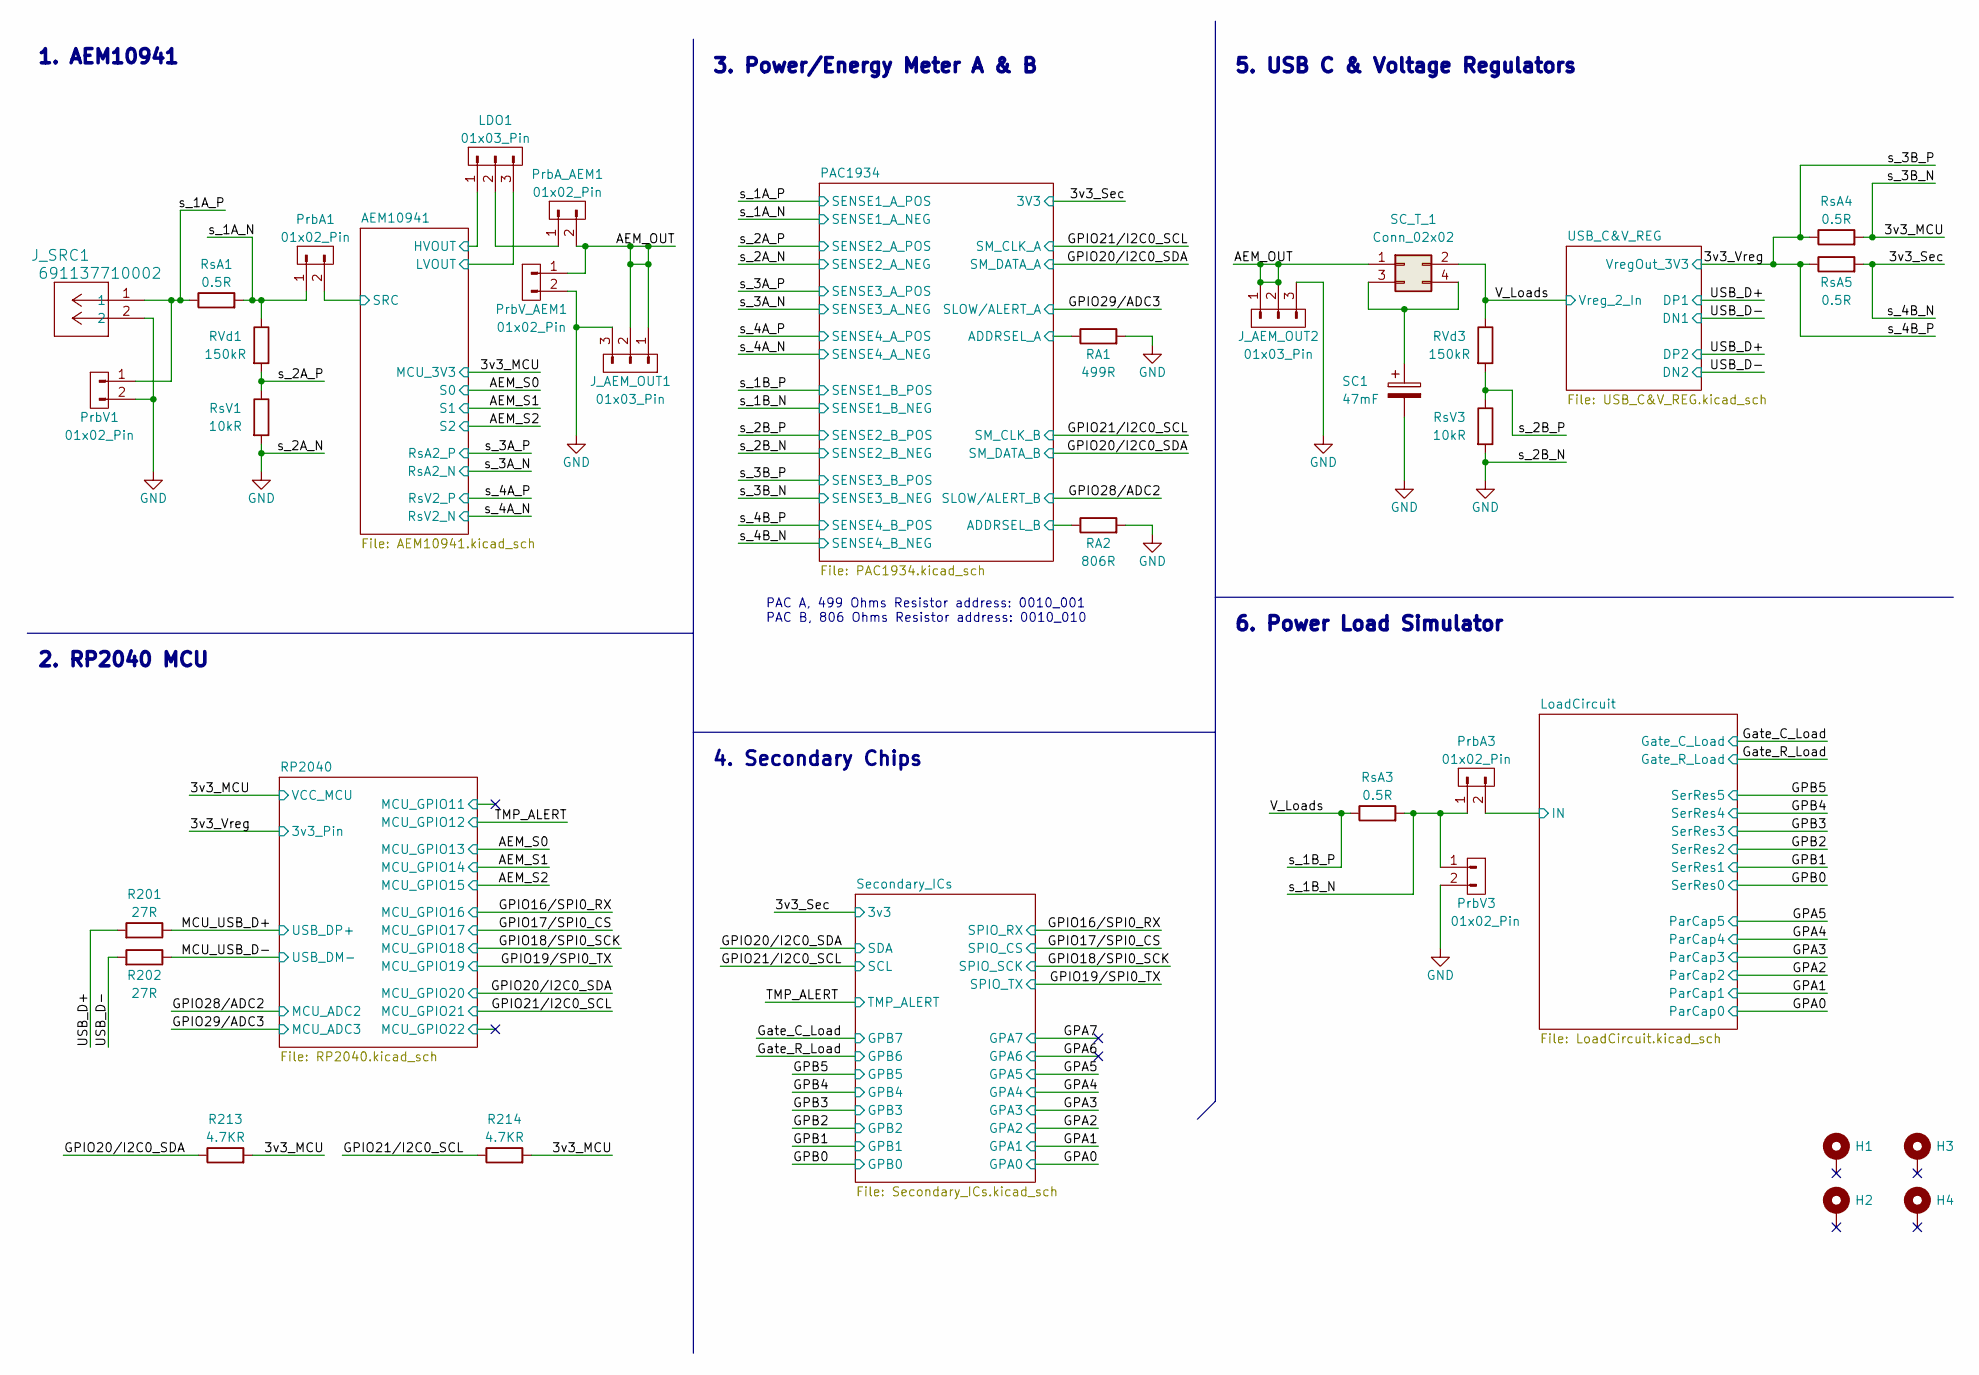
[picture p8: schematic SolarEnergyManager_v1.0.kicad_sch, Solar Energy Manager]

Parts:
H1, H2, H3, H4: MountingHole_Pad; MountingHole_3.2mm_M3_Pad
J_AEM_OUT1, J_AEM_OUT2: 01x03_Pin; PinHeader_1x03_P2.54mm_Vertical
J_SRC1: 691137710002; CONN2_710002_WRE
LDO1: 01x03_Pin; PinHeader_1x03_P2.54mm_Vertical
PrbA1, PrbA3: 01x02_Pin; PinHeader_1x02_P2.54mm_Vertical
PrbA_AEM1: 01x02_Pin; PinHeader_1x02_P2.54mm_Vertical
PrbV1, PrbV3: 01x02_Pin; PinHeader_1x02_P2.54mm_Vertical
PrbV_AEM1: 01x02_Pin; PinHeader_1x02_P2.54mm_Vertical
R201, R202: 27R; R_0402_1005Metric
R213, R214: 4.7KR; R_0402_1005Metric
RA1: 499R; R_0402_1005Metric
RA2: 806R; R_0402_1005Metric
RVd1, RVd3: 150kR; R_0402_1005Metric
RsA1, RsA3, RsA4, RsA5: 0.5R; R_0805_2012Metric
RsV1, RsV3: 10kR; R_0402_1005Metric
SC1: 47mF; Capacitor_Radial_D12mm_P6.8mm
SC_T_1: Conn_02x02; PinHeader_2x02_P2.54mm_Vertical

Connections:
/3v3_MCU: R213.2, R214.2, RsA4.2; also elsewhere on the board
/3v3_Sec: RsA5.2; also elsewhere on the board
/3v3_Vreg: RsA4.1, RsA5.1; also elsewhere on the board
/AEM10941/HVOUT: LDO1.1; also elsewhere on the board
/AEM10941/LVOUT: LDO1.3; also elsewhere on the board
/AEM10941/SRC: PrbA1.2; also elsewhere on the board
/AEM_OUT: J_AEM_OUT1.1, J_AEM_OUT1.2, J_AEM_OUT2.1, J_AEM_OUT2.2, PrbA_AEM1.2, PrbV_AEM1.1, SC_T_1.1
/GPIO20/I2C0_SDA: R213.1; also elsewhere on the board
/GPIO21/I2C0_SCL: R214.1; also elsewhere on the board
/LoadCircuit/IN: PrbA3.2; also elsewhere on the board
/MCU_USB_D+: R201.1; also elsewhere on the board
/MCU_USB_D-: R202.1; also elsewhere on the board
/PAC1934/ADDRSEL_A: RA1.1; also elsewhere on the board
/PAC1934/ADDRSEL_B: RA2.1; also elsewhere on the board
/USB_D+: R201.2; also elsewhere on the board
/USB_D-: R202.2; also elsewhere on the board
/V_Loads: RVd3.1, RsA3.1, SC_T_1.2; also elsewhere on the board
/s_1A_N: PrbA1.1, RVd1.1, RsA1.2; also elsewhere on the board
/s_1A_P: J_SRC1.1, PrbV1.1, RsA1.1; also elsewhere on the board
/s_1B_N: PrbA3.1, PrbV3.1, RsA3.2; also elsewhere on the board
/s_2A_P: RVd1.2, RsV1.1; also elsewhere on the board
/s_2B_P: RVd3.2, RsV3.1; also elsewhere on the board
GND: J_AEM_OUT1.3, J_AEM_OUT2.3, J_SRC1.2, PrbV1.2, PrbV3.2, PrbV_AEM1.2, RA1.2, RA2.2, RsV1.2, RsV3.2, SC1.2; also elsewhere on the board
unnamed: LDO1.2, PrbA_AEM1.1
unnamed: SC1.1, SC_T_1.3, SC_T_1.4

Notes on the sheet:
3. Power/Energy Meter A & B
6. Power Load Simulator
5. USB C & Voltage Regulators
2. RP2040 MCU
PAC A, 499 Ohms Resistor address: 0010_001 PAC B, 806 Ohms Resistor address: 0010_010
1. AEM10941
4. Secondary Chips

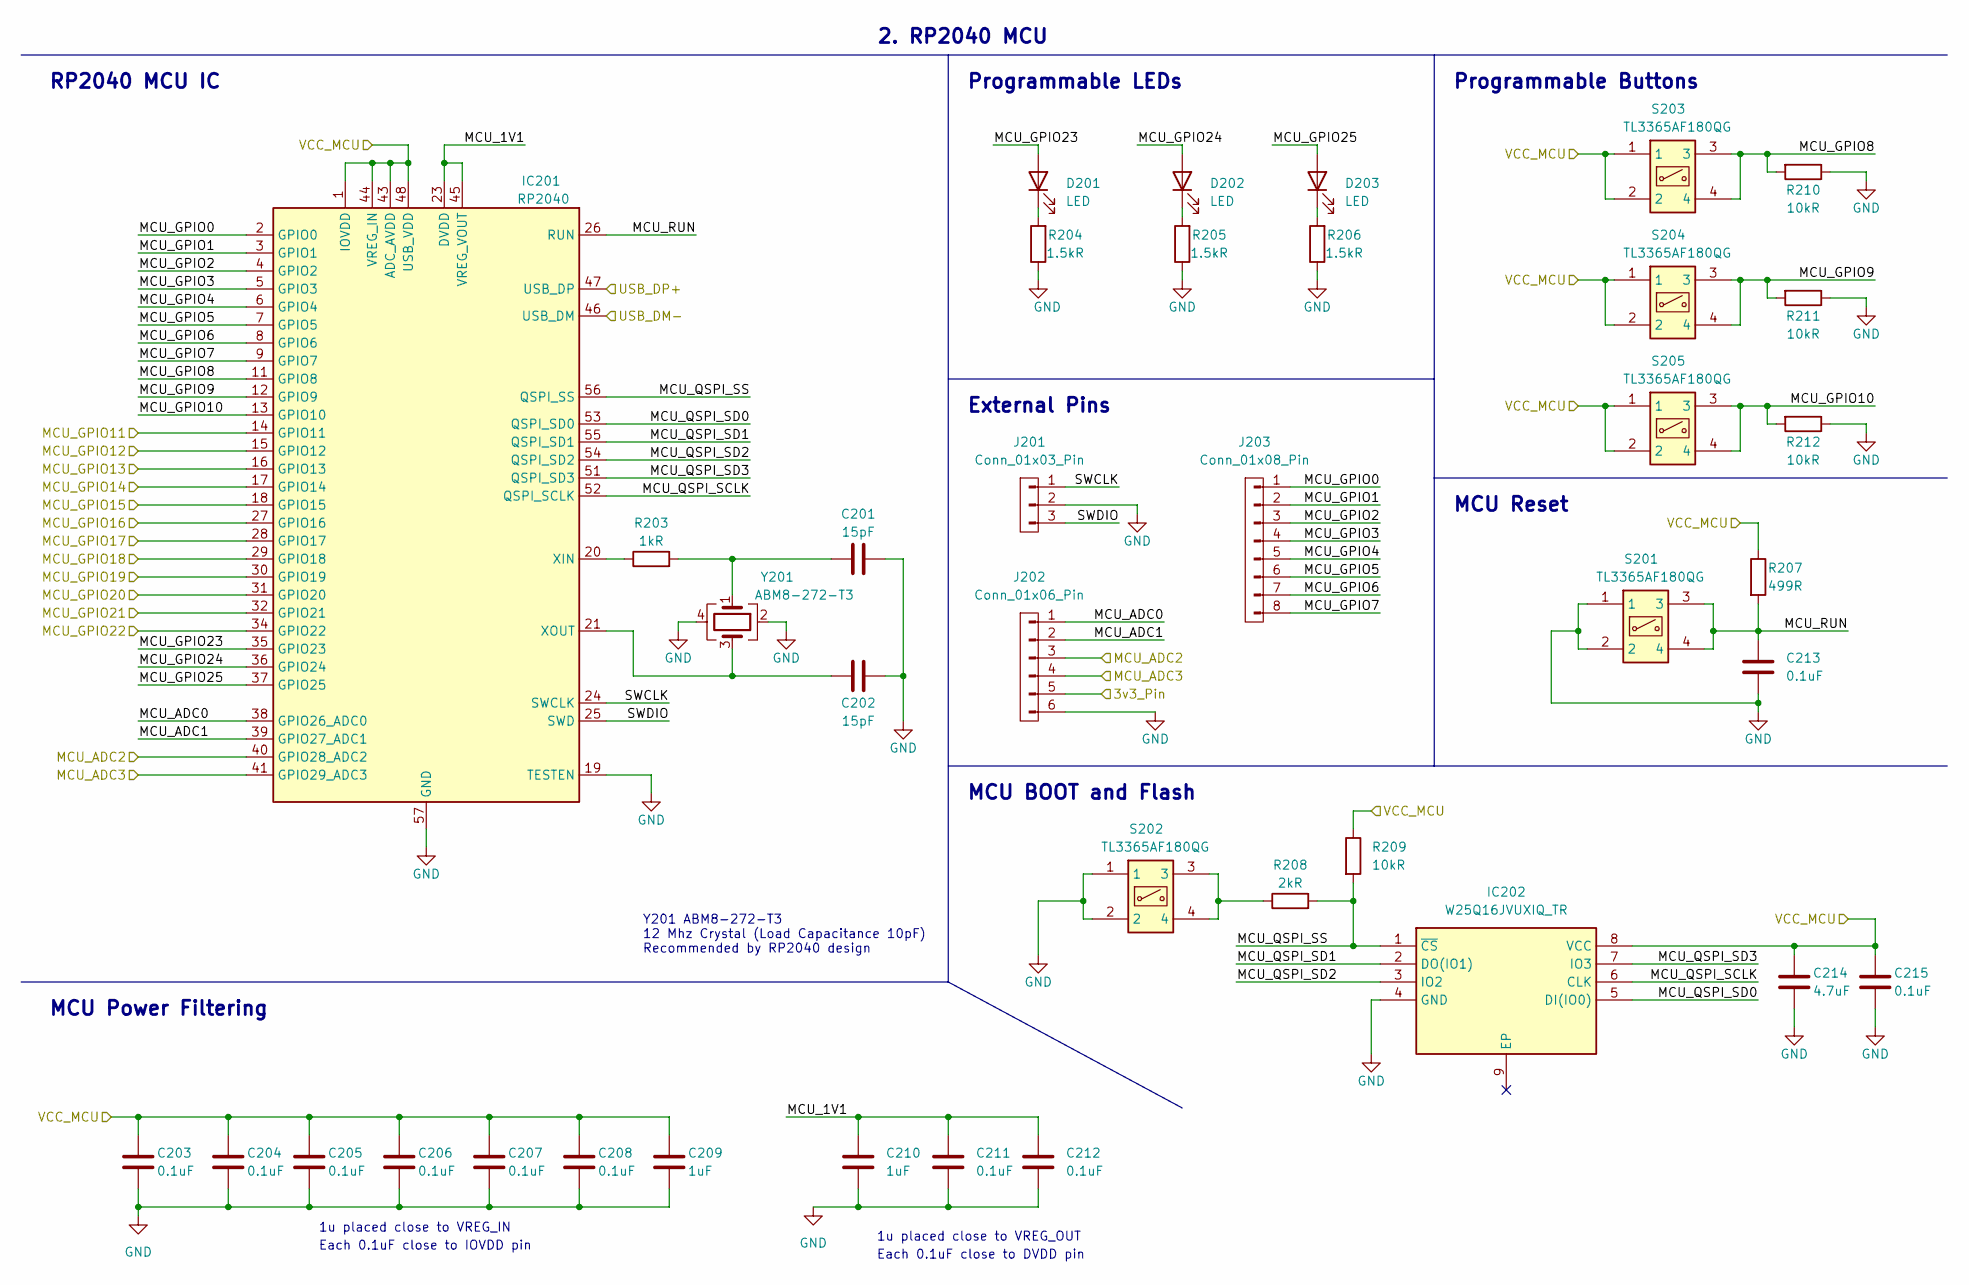
[picture p9: schematic RP2040.kicad_sch, Solar Energy Manager]

Parts:
C201, C202: 15pF; C_0402_1005Metric
C203, C204, C205, C206, C207, C208, C211, C212, C213, C215: 0.1uF; C_0402_1005Metric
C209, C210: 1uF; C_0402_1005Metric
C214: 4.7uF; C_0402_1005Metric
D201, D202, D203: LED; LED_0402_1005Metric
IC201: RP2040; QFN-56-1EP_7x7mm_P0.4mm_EP3.2x3.2mm
IC202: W25Q16JVUXIQ_TR; SON50P300X200X60-9N; Mouser Part Number 454-W25Q16JVUXIQTR
J201: Conn_01x03_Pin; PinSocket_1x03_P2.54mm_Vertical
J202: Conn_01x06_Pin; PinSocket_1x06_P2.54mm_Vertical
J203: Conn_01x08_Pin; PinSocket_1x08_P2.54mm_Vertical
R203: 1kR; R_0402_1005Metric
R204, R205, R206: 1.5kR; R_0402_1005Metric
R207: 499R; R_0402_1005Metric
R208: 2kR; R_0402_1005Metric
R209, R210, R211, R212: 10kR; R_0402_1005Metric
S201, S202, S203, S204, S205: TL3365AF180QG; Mouser Part Number 612-TL3365AF180QG
Y201: ABM8-272-T3; ABM8272T3

Connections:
/3v3_MCU: C203.1, C204.1, C205.1, C206.1, C207.1, C208.1, C209.1, C214.1, C215.1, IC201.1 (IOVDD), IC201.10 (IOVDD), IC201.22 (IOVDD), IC201.33 (IOVDD), IC201.42 (IOVDD), IC201.43 (ADC_AVDD), IC201.44 (VREG_IN), IC201.48 (USB_VDD), IC201.49 (IOVDD), IC202.8 (VCC), R207.1, R209.1, S203.1, S203.2, S204.1, S204.2, S205.1, S205.2; also elsewhere on the board
/3v3_Vreg: J202.5; also elsewhere on the board
/AEM_S0: IC201.16 (GPIO13); also elsewhere on the board
/AEM_S1: IC201.17 (GPIO14); also elsewhere on the board
/AEM_S2: IC201.18 (GPIO15); also elsewhere on the board
/GPIO16/SPI0_RX: IC201.27 (GPIO16); also elsewhere on the board
/GPIO17/SPI0_CS: IC201.28 (GPIO17); also elsewhere on the board
/GPIO18/SPI0_SCK: IC201.29 (GPIO18); also elsewhere on the board
/GPIO19/SPI0_TX: IC201.30 (GPIO19); also elsewhere on the board
/GPIO20/I2C0_SDA: IC201.31 (GPIO20); also elsewhere on the board
/GPIO21/I2C0_SCL: IC201.32 (GPIO21); also elsewhere on the board
/GPIO28/ADC2: IC201.40 (GPIO28_ADC2), J202.3; also elsewhere on the board
/GPIO29/ADC3: IC201.41 (GPIO29_ADC3), J202.4; also elsewhere on the board
/MCU_USB_D+: IC201.47 (USB_DP); also elsewhere on the board
/MCU_USB_D-: IC201.46 (USB_DM); also elsewhere on the board
/RP2040/MCU_1V1: C210.1, C211.1, C212.1, IC201.23 (DVDD), IC201.45 (VREG_VOUT), IC201.50 (DVDD)
/RP2040/MCU_ADC0: IC201.38 (GPIO26_ADC0), J202.1
/RP2040/MCU_ADC1: IC201.39 (GPIO27_ADC1), J202.2
/RP2040/MCU_GPIO0: IC201.2 (GPIO0), J203.1
/RP2040/MCU_GPIO1: IC201.3 (GPIO1), J203.2
/RP2040/MCU_GPIO2: IC201.4 (GPIO2), J203.3
/RP2040/MCU_GPIO3: IC201.5 (GPIO3), J203.4
/RP2040/MCU_GPIO4: IC201.6 (GPIO4), J203.5
/RP2040/MCU_GPIO5: IC201.7 (GPIO5), J203.6
/RP2040/MCU_GPIO6: IC201.8 (GPIO6), J203.7
/RP2040/MCU_GPIO7: IC201.9 (GPIO7), J203.8
/RP2040/MCU_GPIO8: IC201.11 (GPIO8), R210.2, S203.3, S203.4
/RP2040/MCU_GPIO9: IC201.12 (GPIO9), R211.2, S204.3, S204.4
/RP2040/MCU_GPIO10: IC201.13 (GPIO10), R212.2, S205.3, S205.4
/RP2040/MCU_GPIO11: IC201.14 (GPIO11)
/RP2040/MCU_GPIO22: IC201.34 (GPIO22)
/RP2040/MCU_GPIO23: D201.2 (A), IC201.35 (GPIO23)
/RP2040/MCU_GPIO24: D202.2 (A), IC201.36 (GPIO24)
/RP2040/MCU_GPIO25: D203.2 (A), IC201.37 (GPIO25)
/RP2040/MCU_QSPI_SCLK: IC201.52 (QSPI_SCLK), IC202.6 (CLK)
/RP2040/MCU_QSPI_SD0: IC201.53 (QSPI_SD0), IC202.5 (DI(IO0))
/RP2040/MCU_QSPI_SD1: IC201.55 (QSPI_SD1), IC202.2 (DO(IO1))
/RP2040/MCU_QSPI_SD2: IC201.54 (QSPI_SD2), IC202.3 (IO2)
/RP2040/MCU_QSPI_SD3: IC201.51 (QSPI_SD3), IC202.7 (IO3)
/RP2040/MCU_QSPI_SS: IC201.56 (QSPI_SS), IC202.1 (~CS), R208.2, R209.2
/RP2040/MCU_RUN: C213.1, IC201.26 (RUN), R207.2, S201.3, S201.4
/RP2040/SWCLK: IC201.24 (SWCLK), J201.1
/RP2040/SWDIO: IC201.25 (SWD), J201.3
/TMP_ALERT: IC201.15 (GPIO12); also elsewhere on the board
GND: C201.2, C202.2, C203.2, C204.2, C205.2, C206.2, C207.2, C208.2, C209.2, C210.2, C211.2, C212.2, C213.2, C214.2, C215.2, IC201.19 (TESTEN), IC201.57 (GND), IC202.4 (GND), J201.2, J202.6, R204.1, R205.1, R206.1, R210.1, R211.1, R212.1, S201.1, S201.2, S202.1, S202.2, Y201.2, Y201.4; also elsewhere on the board
unnamed: C201.1, R203.2, Y201.1
unnamed: D201.1 (K), R204.2
unnamed: D202.1 (K), R205.2
unnamed: D203.1 (K), R206.2
unnamed: IC201.20 (XIN), R203.1
unnamed: C202.1, IC201.21 (XOUT), Y201.3
unnamed: R208.1, S202.3, S202.4

Notes on the sheet:
External Pins
MCU Reset
Each 0.1uF close to DVDD pin
Y201 ABM8-272-T3 12 Mhz Crystal (Load Capacitance 10pF) Recommended by RP2040 design
1u placed close to VREG_OUT
MCU Power Filtering
2. RP2040 MCU
MCU BOOT and Flash
Each 0.1uF close to IOVDD pin
1u placed close to VREG_IN
Programmable Buttons
Programmable LEDs
RP2040 MCU IC

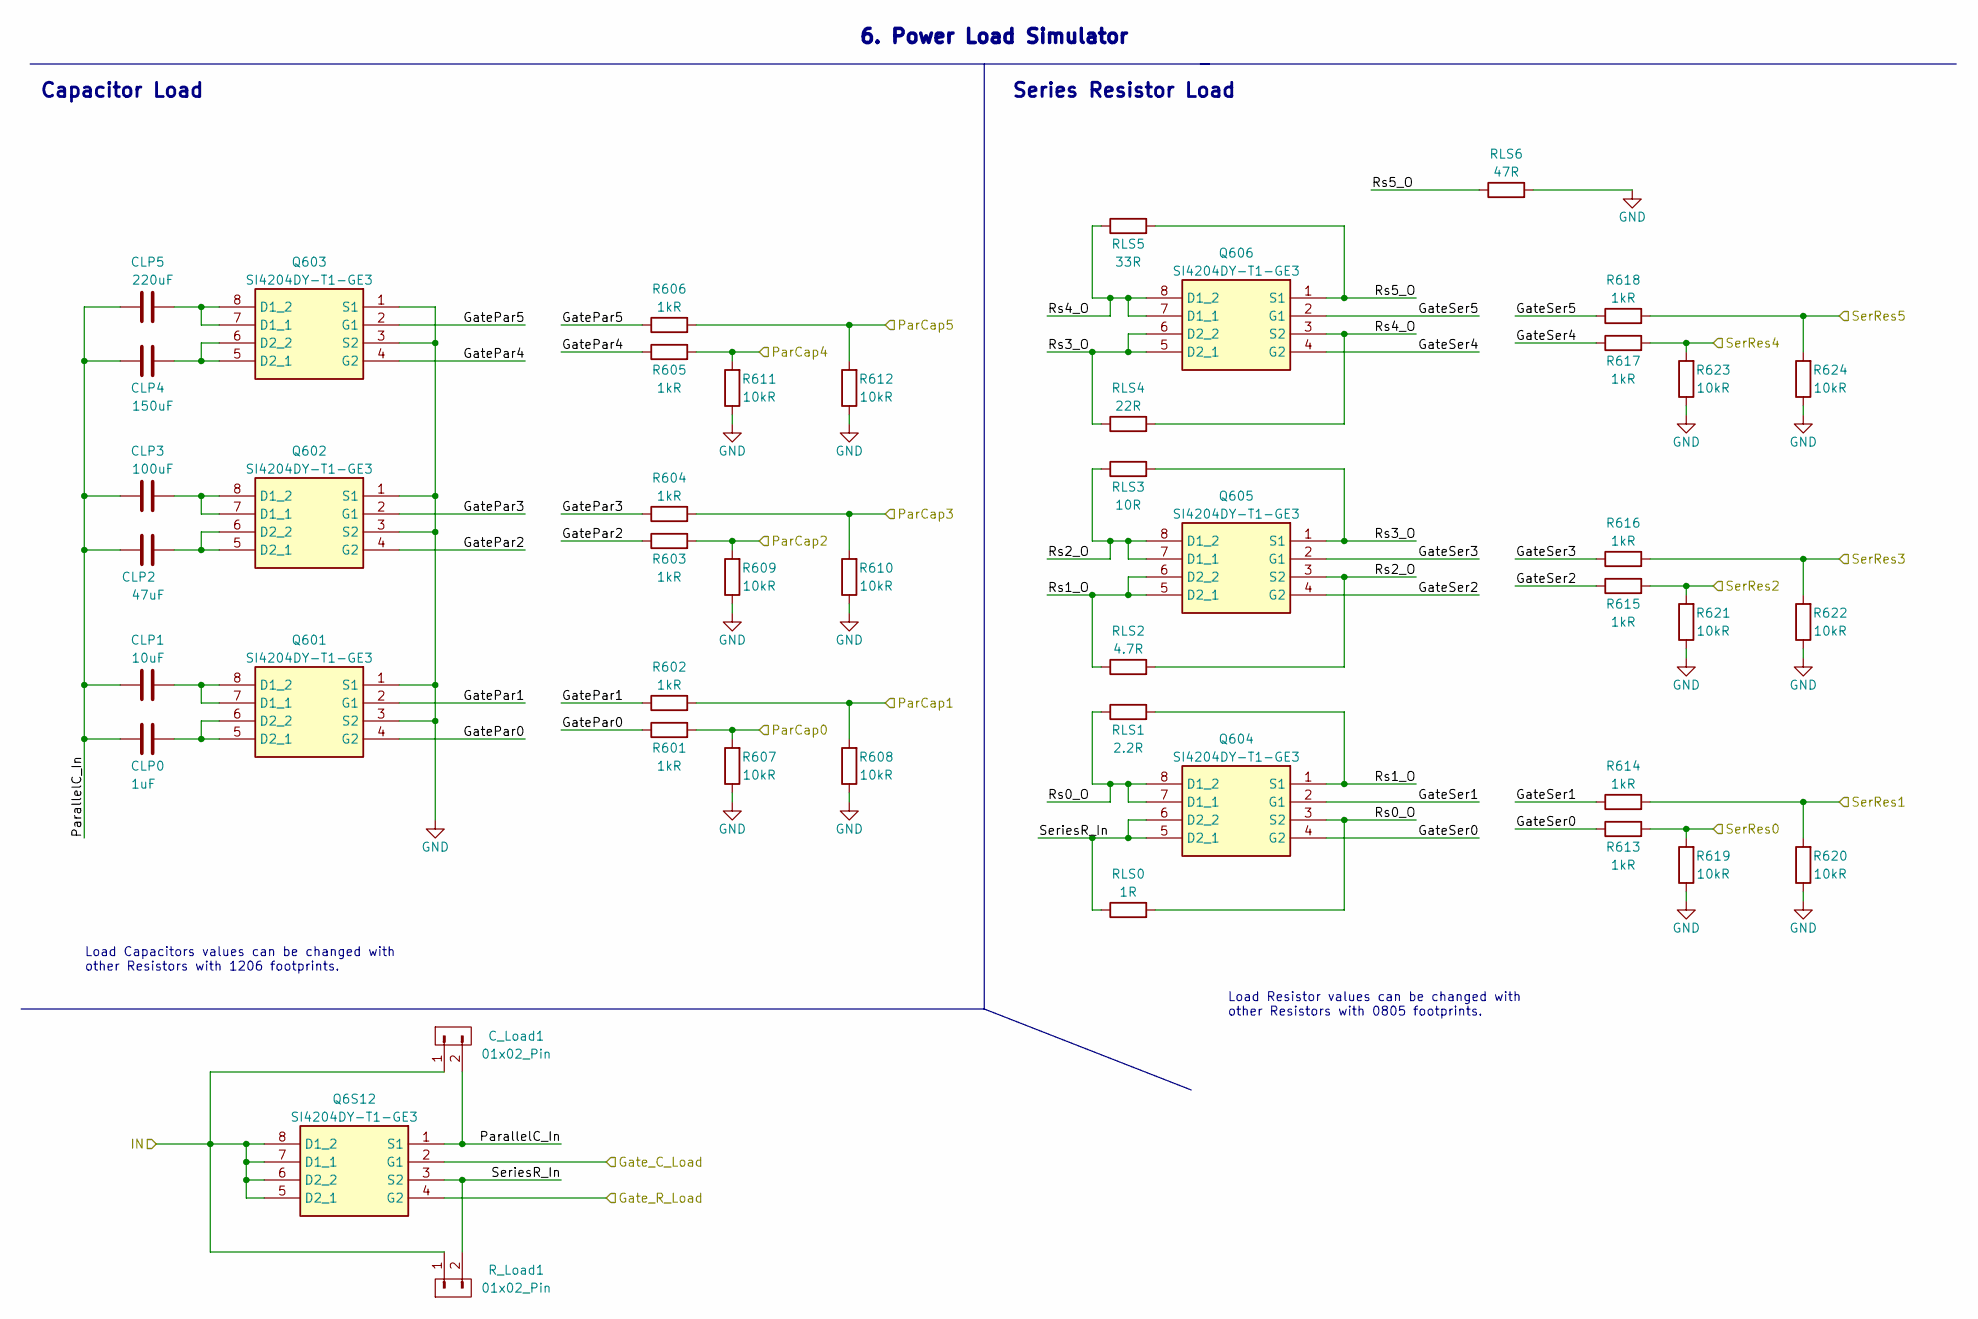
[picture p10: schematic LoadCircuit.kicad_sch, Solar Energy Manager]

Parts:
CLP0: 1uF; C_1206_3216Metric
CLP1: 10uF; C_1206_3216Metric
CLP2: 47uF; C_1206_3216Metric
CLP3: 100uF; C_1206_3216Metric
CLP4: 150uF; C_1206_3216Metric
CLP5: 220uF; C_1206_3216Metric
C_Load1: 01x02_Pin; PinHeader_1x02_P2.54mm_Vertical
Q6S12, Q601, Q602, Q603, Q604, Q605, Q606: SI4204DY-T1-GE3; SOIC127P600X175-8N; Mouser Part Number 781-SI4204DY-T1-GE3
R601, R602, R603, R604, R605, R606, R613, R614, R615, R616, R617, R618: 1kR; R_0402_1005Metric
R607, R608, R609, R610, R611, R612, R619, R620, R621, R622, R623, R624: 10kR; R_0402_1005Metric
RLS0: 1R; R_0805_2012Metric
RLS1: 2.2R; R_0805_2012Metric
RLS2: 4.7R; R_0805_2012Metric
RLS3: 10R; R_0805_2012Metric
RLS4: 22R; R_0805_2012Metric
RLS5: 33R; R_0805_2012Metric
RLS6: 47R; R_0805_2012Metric
R_Load1: 01x02_Pin; PinHeader_1x02_P2.54mm_Vertical

Connections:
/GPA0: R601.2, R607.2; also elsewhere on the board
/GPA1: R602.2, R608.2; also elsewhere on the board
/GPA2: R603.2, R609.2; also elsewhere on the board
/GPA3: R604.2, R610.2; also elsewhere on the board
/GPA4: R605.2, R611.2; also elsewhere on the board
/GPA5: R606.2, R612.2; also elsewhere on the board
/GPB0: R613.2, R619.2; also elsewhere on the board
/GPB1: R614.2, R620.2; also elsewhere on the board
/GPB2: R615.2, R621.2; also elsewhere on the board
/GPB3: R616.2, R622.2; also elsewhere on the board
/GPB4: R617.2, R623.2; also elsewhere on the board
/GPB5: R618.2, R624.2; also elsewhere on the board
/Gate_C_Load: Q6S12.2 (G1); also elsewhere on the board
/Gate_R_Load: Q6S12.4 (G2); also elsewhere on the board
/LoadCircuit/GatePar0: Q601.4 (G2), R601.1
/LoadCircuit/GatePar1: Q601.2 (G1), R602.1
/LoadCircuit/GatePar2: Q602.4 (G2), R603.1
/LoadCircuit/GatePar3: Q602.2 (G1), R604.1
/LoadCircuit/GatePar4: Q603.4 (G2), R605.1
/LoadCircuit/GatePar5: Q603.2 (G1), R606.1
/LoadCircuit/GateSer0: Q604.4 (G2), R613.1
/LoadCircuit/GateSer1: Q604.2 (G1), R614.1
/LoadCircuit/GateSer2: Q605.4 (G2), R615.1
/LoadCircuit/GateSer3: Q605.2 (G1), R616.1
/LoadCircuit/GateSer4: Q606.4 (G2), R617.1
/LoadCircuit/GateSer5: Q606.2 (G1), R618.1
/LoadCircuit/IN: C_Load1.1, Q6S12.5 (D2_1), Q6S12.6 (D2_2), Q6S12.7 (D1_1), Q6S12.8 (D1_2), R_Load1.1; also elsewhere on the board
/LoadCircuit/ParallelC_In: CLP0.1, CLP1.1, CLP2.1, CLP3.1, CLP4.1, CLP5.1, C_Load1.2, Q6S12.1 (S1)
/LoadCircuit/Rs0_O: Q604.3 (S2), Q604.7 (D1_1), Q604.8 (D1_2), RLS0.2, RLS1.1
/LoadCircuit/Rs1_O: Q604.1 (S1), Q605.5 (D2_1), Q605.6 (D2_2), RLS1.2, RLS2.1
/LoadCircuit/Rs2_O: Q605.3 (S2), Q605.7 (D1_1), Q605.8 (D1_2), RLS2.2, RLS3.1
/LoadCircuit/Rs3_O: Q605.1 (S1), Q606.5 (D2_1), Q606.6 (D2_2), RLS3.2, RLS4.1
/LoadCircuit/Rs4_O: Q606.3 (S2), Q606.7 (D1_1), Q606.8 (D1_2), RLS4.2, RLS5.1
/LoadCircuit/Rs5_O: Q606.1 (S1), RLS5.2, RLS6.1
/LoadCircuit/SeriesR_In: Q6S12.3 (S2), Q604.5 (D2_1), Q604.6 (D2_2), RLS0.1, R_Load1.2
GND: Q601.1 (S1), Q601.3 (S2), Q602.1 (S1), Q602.3 (S2), Q603.1 (S1), Q603.3 (S2), R607.1, R608.1, R609.1, R610.1, R611.1, R612.1, R619.1, R620.1, R621.1, R622.1, R623.1, R624.1, RLS6.2; also elsewhere on the board
unnamed: CLP1.2, Q601.7 (D1_1), Q601.8 (D1_2)
unnamed: CLP0.2, Q601.5 (D2_1), Q601.6 (D2_2)
unnamed: CLP3.2, Q602.7 (D1_1), Q602.8 (D1_2)
unnamed: CLP2.2, Q602.5 (D2_1), Q602.6 (D2_2)
unnamed: CLP5.2, Q603.7 (D1_1), Q603.8 (D1_2)
unnamed: CLP4.2, Q603.5 (D2_1), Q603.6 (D2_2)

Notes on the sheet:
Series Resistor Load
Load Resistor values can be changed with other Resistors with 0805 footprints.
6. Power Load Simulator
Load Capacitors values can be changed with other Resistors with 1206 footprints.
Capacitor Load

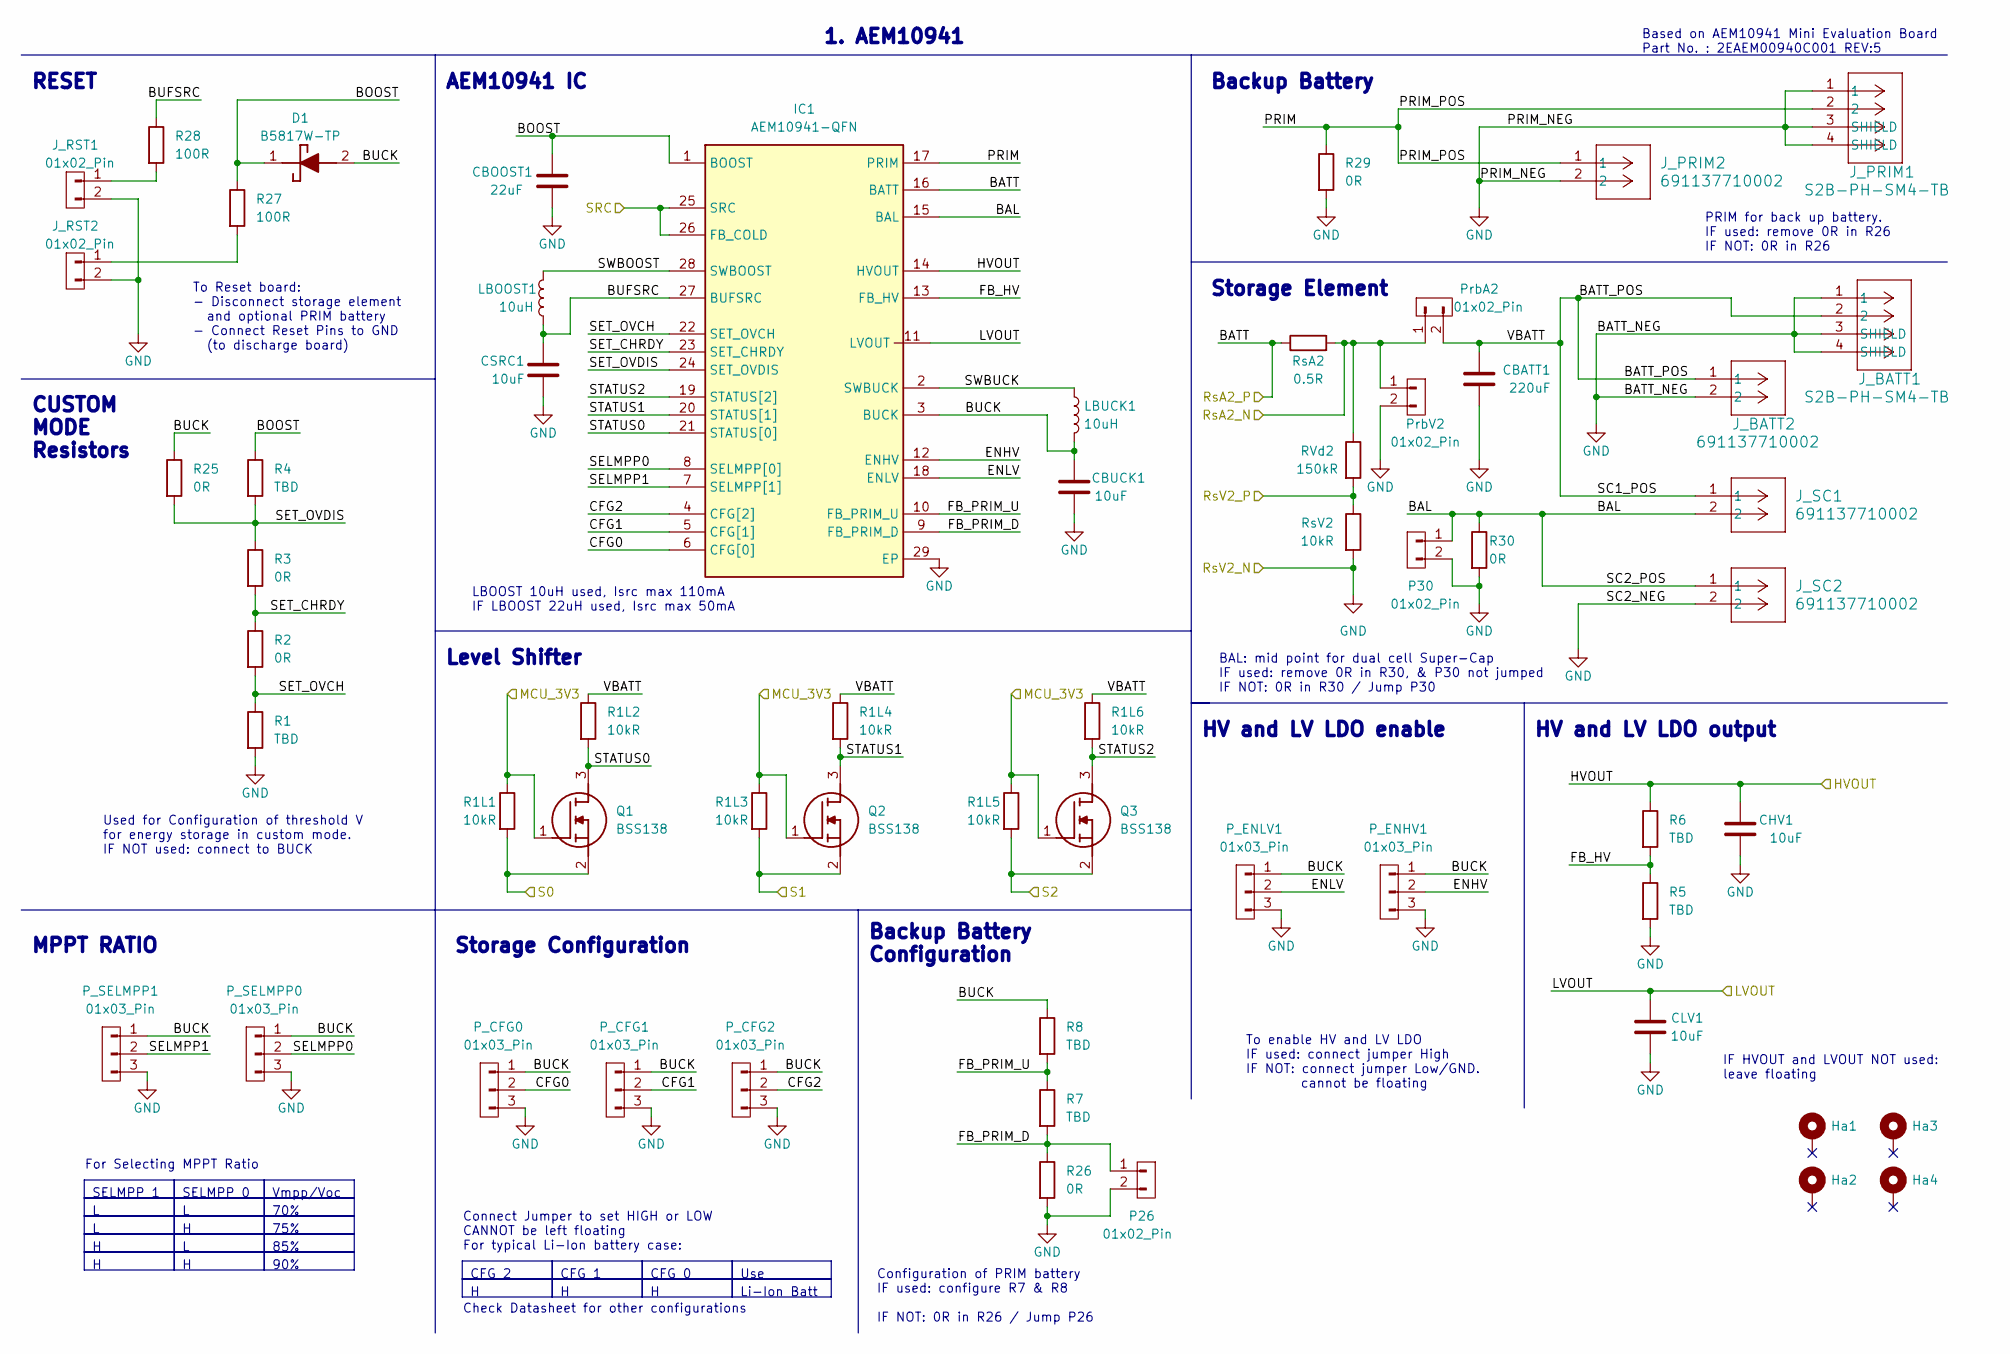
[picture p11: schematic AEM10941.kicad_sch, Solar Energy Manager]

Parts:
CBATT1: 220uF; C_1206_3216Metric
CBOOST1: 22uF; C_0603_1608Metric
CBUCK1: 10uF; C_0603_1608Metric
CHV1: 10uF; C_0603_1608Metric
CLV1: 10uF; C_0603_1608Metric
CSRC1: 10uF; C_0603_1608Metric
D1: B5817W-TP; SOD3716X135N; Mouser Part Number 833-B5817W-TP
Ha1, Ha2, Ha3, Ha4: MountingHole_Pad; MountingHole_3.2mm_M3_Pad
IC1: AEM10941-QFN; QFN50P500X500X90-29N-D; Mouser Part Number 120-AEM10941-QFN
J_BATT1: S2B-PH-SM4-TB; CONN_S2B-PH-SM4-TB_JST
J_BATT2: 691137710002; CONN2_710002_WRE
J_PRIM1: S2B-PH-SM4-TB; CONN_S2B-PH-SM4-TB_JST
J_PRIM2: 691137710002; CONN2_710002_WRE
J_RST1, J_RST2: 01x02_Pin; PinHeader_1x02_P2.54mm_Vertical
J_SC1, J_SC2: 691137710002; CONN2_710002_WRE
LBOOST1: 10uH; L_Vishay_IFSC-1515AH_4x4x1.8mm
LBUCK1: 10uH; L_0603_1608Metric
P26, P30: 01x02_Pin; PinHeader_1x02_P2.54mm_Vertical
P_CFG0, P_CFG1, P_CFG2: 01x03_Pin; PinHeader_1x03_P2.54mm_Vertical
P_ENHV1: 01x03_Pin; PinHeader_1x03_P2.54mm_Vertical
P_ENLV1: 01x03_Pin; PinHeader_1x03_P2.54mm_Vertical
P_SELMPP0, P_SELMPP1: 01x03_Pin; PinHeader_1x03_P2.54mm_Vertical
PrbA2: 01x02_Pin; PinHeader_1x02_P2.54mm_Vertical
PrbV2: 01x02_Pin; PinHeader_1x02_P2.54mm_Vertical
Q1, Q2, Q3: BSS138; SOT95P240X120-3N; Mouser Part Number 512-BSS138
R1, R4, R5, R6, R7, R8: TBD; R_0603_1608Metric
R1L1, R1L2, R1L3, R1L4, R1L5, R1L6: 10kR; R_0402_1005Metric
R2, R3, R25, R26, R29, R30: 0R; R_0603_1608Metric
R27, R28: 100R; R_0603_1608Metric
RVd2: 150kR; R_0402_1005Metric
RsA2: 0.5R; R_0805_2012Metric
RsV2: 10kR; R_0402_1005Metric

Connections:
/3v3_MCU: Q1.1 (G), Q2.1 (G), Q3.1 (G), R1L1.1, R1L3.1, R1L5.1; also elsewhere on the board
/AEM10941/BAL: IC1.15 (BAL), J_SC1.2, J_SC2.1, P30.1, R30.1
/AEM10941/BATT_POS: CBATT1.1, J_BATT1.2, J_BATT2.1, J_SC1.1, PrbA2.2, R1L2.1, R1L4.1, R1L6.1
/AEM10941/BOOST: CBOOST1.1, D1.1 (K), IC1.1 (BOOST), R4.1, R27.1
/AEM10941/BUCK: CBUCK1.1, D1.2 (A), IC1.3 (BUCK), LBUCK1.2, P_CFG0.1, P_CFG1.1, P_CFG2.1, P_ENHV1.1, P_ENLV1.1, P_SELMPP0.1, P_SELMPP1.1, R8.1, R25.1
/AEM10941/BUFSRC: CSRC1.1, IC1.27 (BUFSRC), LBOOST1.2, R28.1
/AEM10941/CFG0: IC1.6 (CFG[0]), P_CFG0.2
/AEM10941/CFG1: IC1.5 (CFG[1]), P_CFG1.2
/AEM10941/CFG2: IC1.4 (CFG[2]), P_CFG2.2
/AEM10941/ENHV: IC1.12 (ENHV), P_ENHV1.2
/AEM10941/ENLV: IC1.18 (ENLV), P_ENLV1.2
/AEM10941/FB_HV: IC1.13 (FB_HV), R5.1, R6.2
/AEM10941/FB_PRIM_D: IC1.9 (FB_PRIM_D), P26.1, R7.2, R26.1
/AEM10941/FB_PRIM_U: IC1.10 (FB_PRIM_U), R7.1, R8.2
/AEM10941/HVOUT: CHV1.1, IC1.14 (HVOUT), R6.1; also elsewhere on the board
/AEM10941/LVOUT: CLV1.1, IC1.11 (LVOUT); also elsewhere on the board
/AEM10941/PRIM: IC1.17 (PRIM), J_PRIM1.2, J_PRIM2.1, R29.1
/AEM10941/SELMPP0: IC1.8 (SELMPP[0]), P_SELMPP0.2
/AEM10941/SELMPP1: IC1.7 (SELMPP[1]), P_SELMPP1.2
/AEM10941/SET_CHRDY: IC1.23 (SET_CHRDY), R2.1, R3.2
/AEM10941/SET_OVCH: IC1.22 (SET_OVCH), R1.1, R2.2
/AEM10941/SET_OVDIS: IC1.24 (SET_OVDIS), R3.1, R4.2, R25.2
/AEM10941/SRC: IC1.25 (SRC), IC1.26 (FB_COLD); also elsewhere on the board
/AEM10941/STATUS0: IC1.21 (STATUS[0]), Q1.3 (D), R1L2.2
/AEM10941/STATUS1: IC1.20 (STATUS[1]), Q2.3 (D), R1L4.2
/AEM10941/STATUS2: IC1.19 (STATUS[2]), Q3.3 (D), R1L6.2
/AEM10941/SWBOOST: IC1.28 (SWBOOST), LBOOST1.1
/AEM10941/SWBUCK: IC1.2 (SWBUCK), LBUCK1.1
/AEM_S0: Q1.2 (S), R1L1.2; also elsewhere on the board
/AEM_S1: Q2.2 (S), R1L3.2; also elsewhere on the board
/AEM_S2: Q3.2 (S), R1L5.2; also elsewhere on the board
/s_3A_N: PrbA2.1, PrbV2.1, RVd2.1, RsA2.2; also elsewhere on the board
/s_3A_P: IC1.16 (BATT), RsA2.1; also elsewhere on the board
/s_4A_P: RVd2.2, RsV2.1; also elsewhere on the board
GND: CBATT1.2, CBOOST1.2, CBUCK1.2, CHV1.2, CLV1.2, CSRC1.2, IC1.29 (EP), J_BATT1.1, J_BATT1.3 (SHIELD), J_BATT1.4 (SHIELD), J_BATT2.2, J_PRIM1.1, J_PRIM1.3 (SHIELD), J_PRIM1.4 (SHIELD), J_PRIM2.2, J_RST1.2, J_RST2.2, J_SC2.2, P26.2, P30.2, P_CFG0.3, P_CFG1.3, P_CFG2.3, P_ENHV1.3, P_ENLV1.3, P_SELMPP0.3, P_SELMPP1.3, PrbV2.2, R1.2, R5.2, R26.2, R29.2, R30.2, RsV2.2; also elsewhere on the board
unnamed: J_RST1.1, R28.2
unnamed: J_RST2.1, R27.2

Notes on the sheet:
90%
Li-Ion Batt
75%
70%
Vmpp/Voc
CFG 0
CFG 2
SELMPP 0
Use
CFG 1
85%
SELMPP 1
IF HVOUT and LVOUT NOT used: leave floating
Check Datasheet for other configurations
Storage Configuration
Connect Jumper to set HIGH or LOW CANNOT be left floating For typical Li-Ion battery case:
CUSTOM MODE Resistors
For Selecting MPPT Ratio
HV and LV LDO output
RESET
HV and LV LDO enable
Backup Battery
To enable HV and LV LDO IF used: connect jumper High IF NOT: connect jumper Low/GND. cannot be floating
1. AEM10941
Based on AEM10941 Mini Evaluation Board Part No. : 2EAEM00940C001 REV:5
BAL: mid point for dual cell Super-Cap IF used: remove 0R in R30, & P30 not jumped IF NOT: 0R in R30 / Jump P30
LBOOST 10uH used, Isrc max 110mA IF LBOOST 22uH used, Isrc max 50mA
AEM10941 IC
Storage Element
To Reset board: - Disconnect storage element and optional PRIM battery - Connect Reset Pins to GND (to discharge board)
MPPT RATIO
Backup Battery Configuration
PRIM for back up battery. IF used: remove 0R in R26 IF NOT: 0R in R26
Used for Configuration of threshold V for energy storage in custom mode. IF NOT used: connect to BUCK
Level Shifter
Configuration of PRIM battery IF used: configure R7 & R8 IF NOT: 0R in R26 / Jump P26

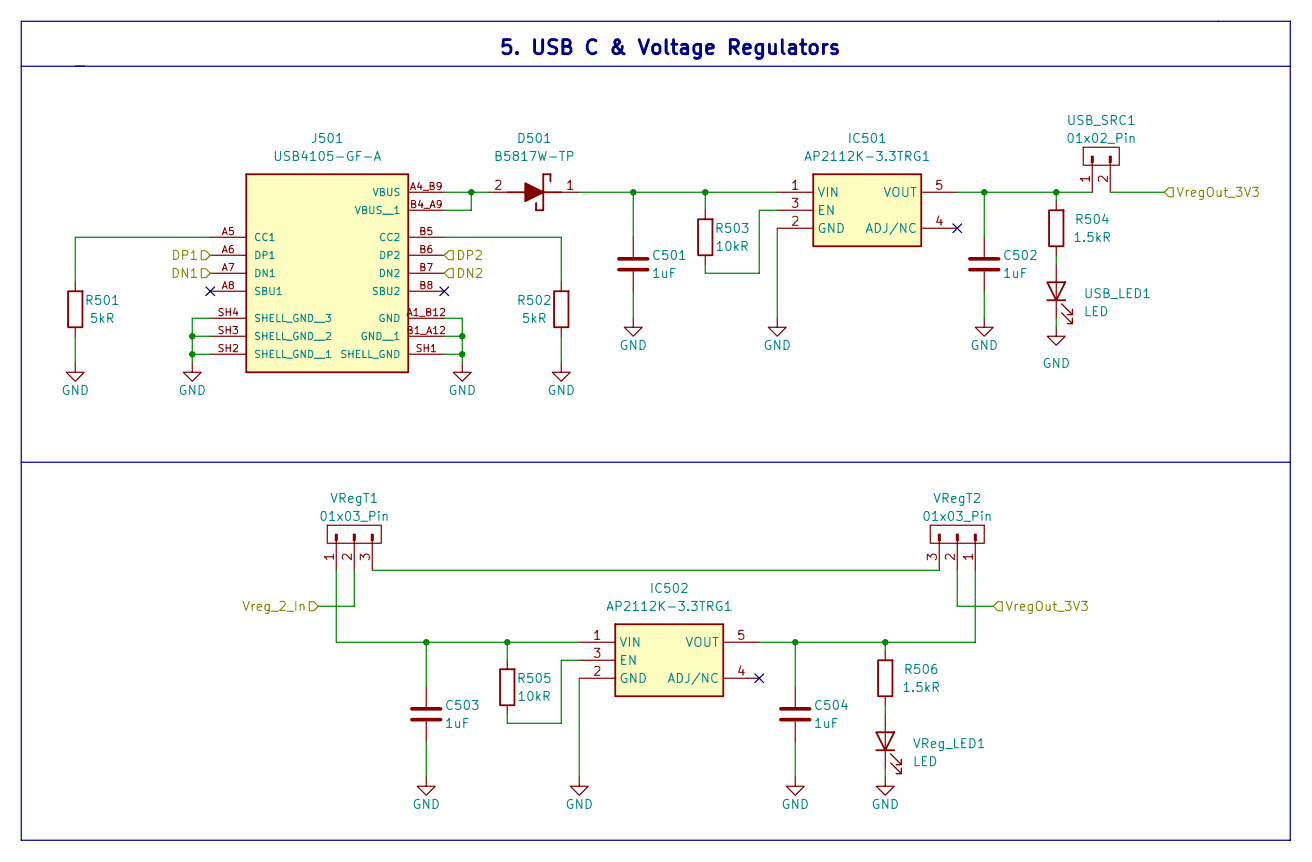
[picture p12: schematic USB_C&V_REG.kicad_sch, Solar Energy Manager]

Parts:
C501, C502, C503, C504: 1uF; C_0402_1005Metric
D501: B5817W-TP; SOD3716X135N; Mouser Part Number 833-B5817W-TP
IC501, IC502: AP2112K-3.3TRG1; SOT95P282X130-5N; Mouser Part Number 621-AP2112K-3.3TRG1
J501: USB4105-GF-A; GCT_USB4105-GF-A; PARTREV B3
R501, R502: 5kR; R_0402_1005Metric
R503, R505: 10kR; R_0402_1005Metric
R504, R506: 1.5kR; R_0402_1005Metric
USB_LED1: LED; LED_0402_1005Metric
USB_SRC1: 01x02_Pin; PinHeader_1x02_P2.54mm_Vertical
VRegT1, VRegT2: 01x03_Pin; PinHeader_1x03_P2.54mm_Vertical
VReg_LED1: LED; LED_0402_1005Metric

Connections:
/3v3_Vreg: USB_SRC1.2, VRegT2.2; also elsewhere on the board
/USB_D+: J501.A6 (DP1), J501.B6 (DP2); also elsewhere on the board
/USB_D-: J501.A7 (DN1), J501.B7 (DN2); also elsewhere on the board
/V_Loads: VRegT1.2; also elsewhere on the board
GND: C501.2, C502.2, C503.2, C504.2, IC501.2 (GND), IC502.2 (GND), J501.A1_B12 (GND), J501.B1_A12 (GND__1), J501.SH1 (SHELL_GND), J501.SH2 (SHELL_GND__1), J501.SH3 (SHELL_GND__2), J501.SH4 (SHELL_GND__3), R501.1, R502.1, USB_LED1.1 (K), VReg_LED1.1 (K); also elsewhere on the board
unnamed: D501.2 (A), J501.A4_B9 (VBUS), J501.B4_A9 (VBUS__1)
unnamed: C501.1, D501.1 (K), IC501.1 (VIN), R503.2
unnamed: IC501.3 (EN), R503.1
unnamed: C502.1, IC501.5 (VOUT), R504.2, USB_SRC1.1
unnamed: IC502.3 (EN), R505.1
unnamed: C503.1, IC502.1 (VIN), R505.2, VRegT1.1
unnamed: C504.1, IC502.5 (VOUT), R506.2, VRegT2.1
unnamed: J501.A5 (CC1), R501.2
unnamed: J501.B5 (CC2), R502.2
unnamed: R504.1, USB_LED1.2 (A)
unnamed: VRegT1.3, VRegT2.3
unnamed: R506.1, VReg_LED1.2 (A)

Notes on the sheet:
5. USB C & Voltage Regulators
