JasonFJ9/BachelorThesisPCBs/SolarEnergyManager_v1.0/SolarEnergyManager_v1.0.kicad_pcb

## KiCad design SolarEnergyManager_v1.0/SolarEnergyManager_v1.0.kicad_pcb (continued)

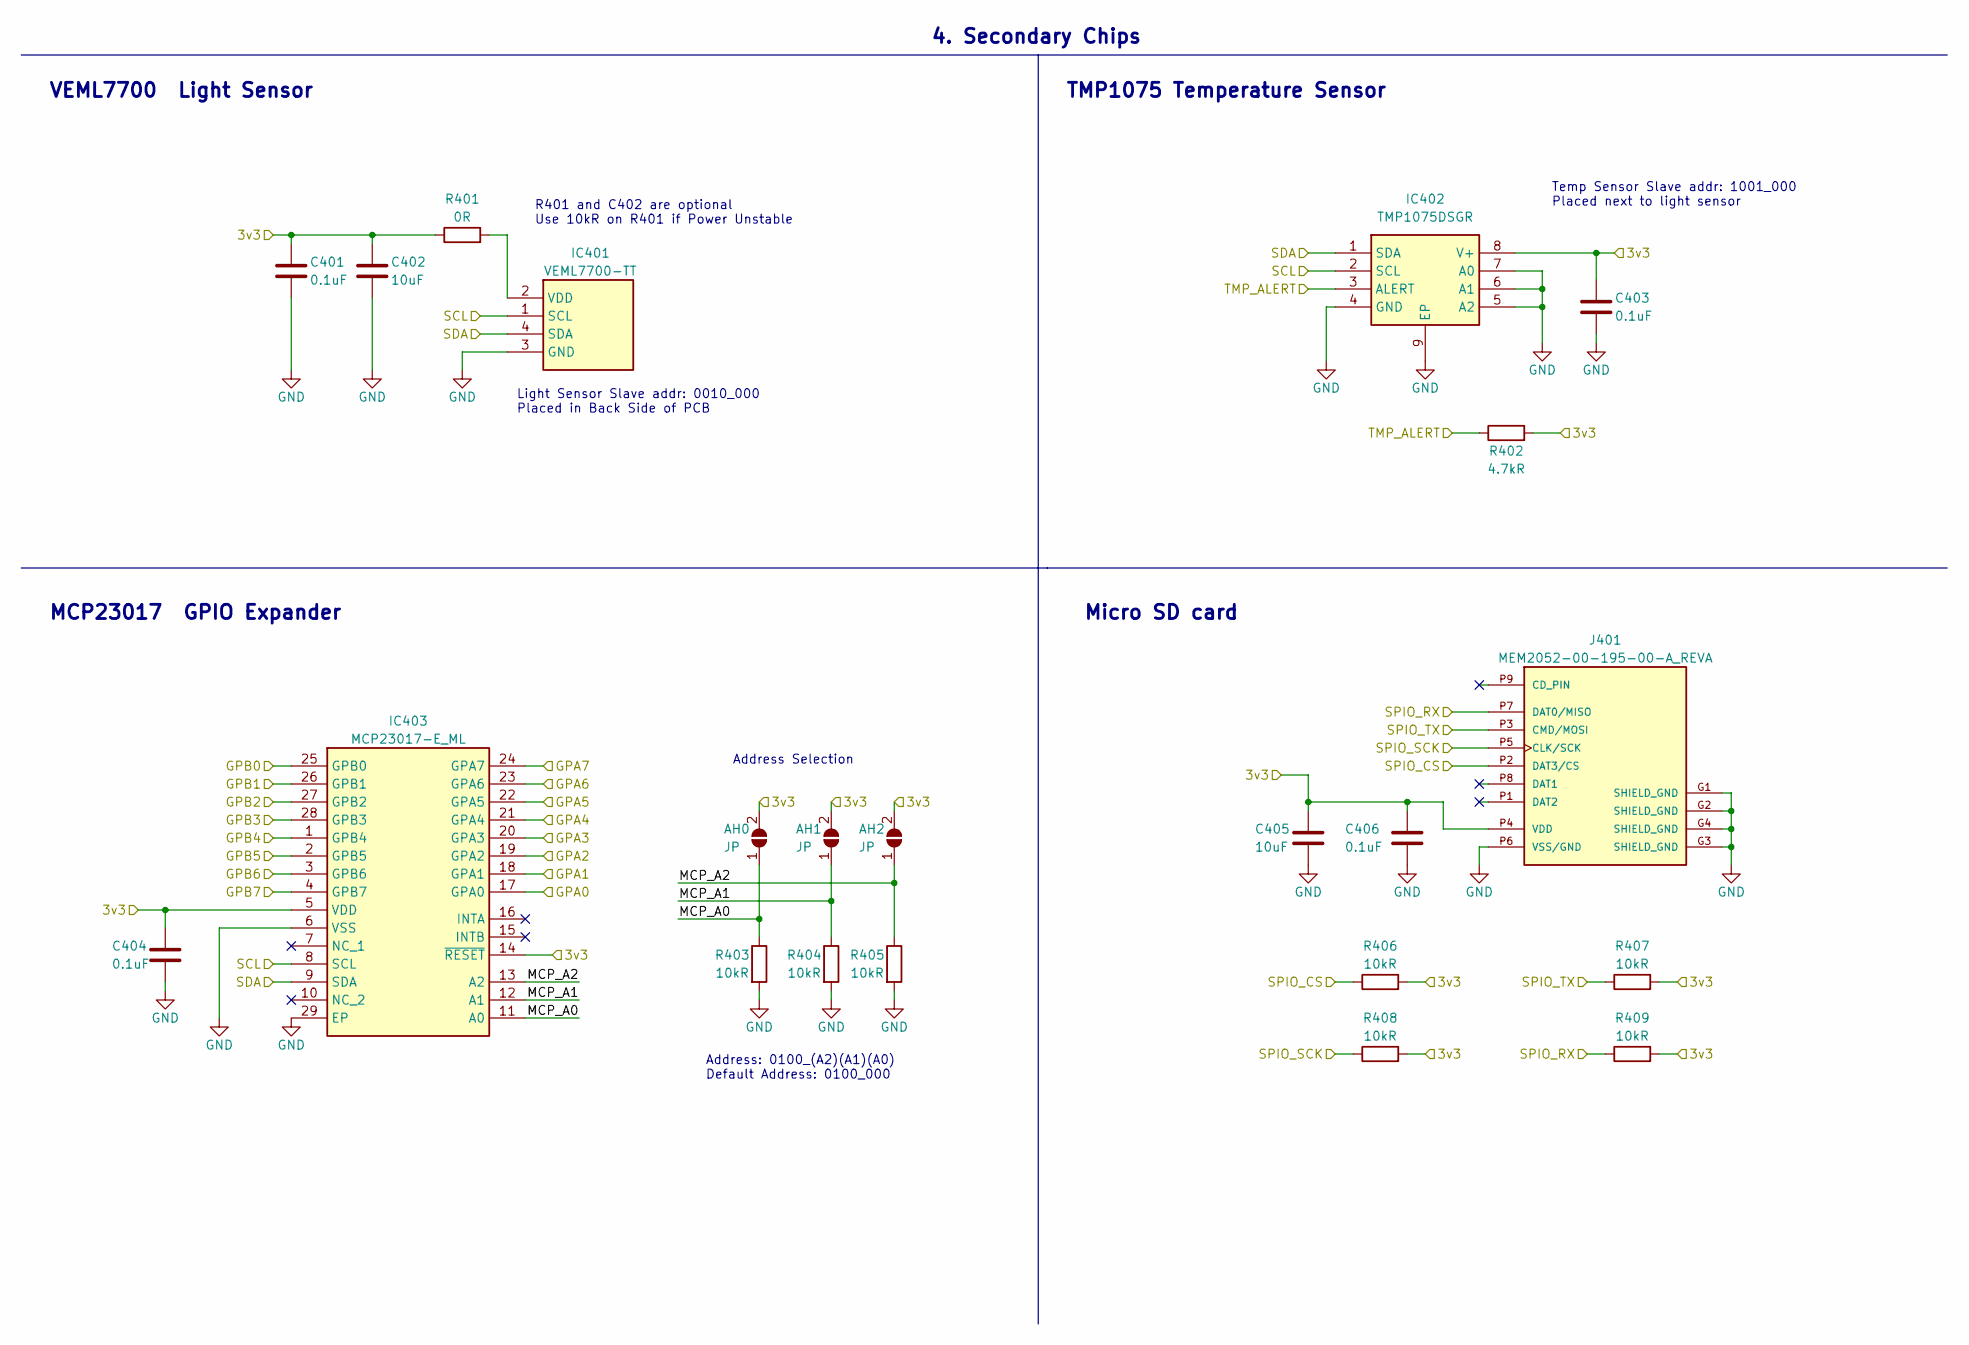
[picture p13: schematic Secondary_ICs.kicad_sch, Solar Energy Manager]

Parts:
AH0, AH1, AH2: JP; SolderJumper-2_P1.3mm_Open_TrianglePad1.0x1.5mm
C401, C403, C404, C406: 0.1uF; C_0402_1005Metric
C402, C405: 10uF; C_0402_1005Metric
IC401: VEML7700-TT; VEML7700; Mouser Part Number 78-VEML7700-TT
IC402: TMP1075DSGR; SON50P200X200X80-9N; Mouser Part Number 595-TMP1075DSGR
IC403: MCP23017-E_ML; QFN65P600X600X100-29N-D; Mouser Part Number 579-MCP23017-E/ML
J401: MEM2052-00-195-00-A_REVA; GCT_MEM2052-00-195-00-A_REVA; PARTREV A
R401: 0R; R_0402_1005Metric
R402: 4.7kR; R_0402_1005Metric
R403, R404, R405, R406, R407, R408, R409: 10kR; R_0402_1005Metric

Connections:
/3v3_Sec: AH0.2 (B), AH1.2 (B), AH2.2 (B), C401.1, C402.1, C403.1, C404.1, C405.1, C406.1, IC402.8 (V+), IC403.5 (VDD), IC403.14 (~RESET), J401.P4 (VDD), R401.1, R402.2, R406.2, R407.2, R408.2, R409.2; also elsewhere on the board
/GPA0: IC403.17 (GPA0); also elsewhere on the board
/GPA1: IC403.18 (GPA1); also elsewhere on the board
/GPA2: IC403.19 (GPA2); also elsewhere on the board
/GPA3: IC403.20 (GPA3); also elsewhere on the board
/GPA4: IC403.21 (GPA4); also elsewhere on the board
/GPA5: IC403.22 (GPA5); also elsewhere on the board
/GPA6: IC403.23 (GPA6)
/GPA7: IC403.24 (GPA7)
/GPB0: IC403.25 (GPB0); also elsewhere on the board
/GPB1: IC403.26 (GPB1); also elsewhere on the board
/GPB2: IC403.27 (GPB2); also elsewhere on the board
/GPB3: IC403.28 (GPB3); also elsewhere on the board
/GPB4: IC403.1 (GPB4); also elsewhere on the board
/GPB5: IC403.2 (GPB5); also elsewhere on the board
/GPIO16/SPI0_RX: J401.P7 (DAT0/MISO), R409.1; also elsewhere on the board
/GPIO17/SPI0_CS: J401.P2 (DAT3/CS), R406.1; also elsewhere on the board
/GPIO18/SPI0_SCK: J401.P5 (CLK/SCK), R408.1; also elsewhere on the board
/GPIO19/SPI0_TX: J401.P3 (CMD/MOSI), R407.1; also elsewhere on the board
/GPIO20/I2C0_SDA: IC401.4 (SDA), IC402.1 (SDA), IC403.9 (SDA); also elsewhere on the board
/GPIO21/I2C0_SCL: IC401.1 (SCL), IC402.2 (SCL), IC403.8 (SCL); also elsewhere on the board
/Gate_C_Load: IC403.4 (GPB7); also elsewhere on the board
/Gate_R_Load: IC403.3 (GPB6); also elsewhere on the board
/Secondary_ICs/MCP_A0: AH0.1 (A), IC403.11 (A0), R403.1
/Secondary_ICs/MCP_A1: AH1.1 (A), IC403.12 (A1), R404.1
/Secondary_ICs/MCP_A2: AH2.1 (A), IC403.13 (A2), R405.1
/TMP_ALERT: IC402.3 (ALERT), R402.1; also elsewhere on the board
GND: C401.2, C402.2, C403.2, C404.2, C405.2, C406.2, IC401.3 (GND), IC402.4 (GND), IC402.5 (A2), IC402.6 (A1), IC402.7 (A0), IC402.9 (EP), IC403.6 (VSS), IC403.29 (EP), J401.G1 (SHIELD_GND), J401.G2 (SHIELD_GND), J401.G3 (SHIELD_GND), J401.G4 (SHIELD_GND), J401.P6 (VSS/GND), R403.2, R404.2, R405.2; also elsewhere on the board
unnamed: IC401.2 (VDD), R401.2

Notes on the sheet:
Address Selection
TMP1075 Temperature Sensor
Temp Sensor Slave addr: 1001_000 Placed next to light sensor
R401 and C402 are optional Use 10kR on R401 if Power Unstable
Micro SD card
MCP23017 GPIO Expander
Light Sensor Slave addr: 0010_000 Placed in Back Side of PCB
Address: 0100_(A2)(A1)(A0) Default Address: 0100_000
4. Secondary Chips
VEML7700 Light Sensor

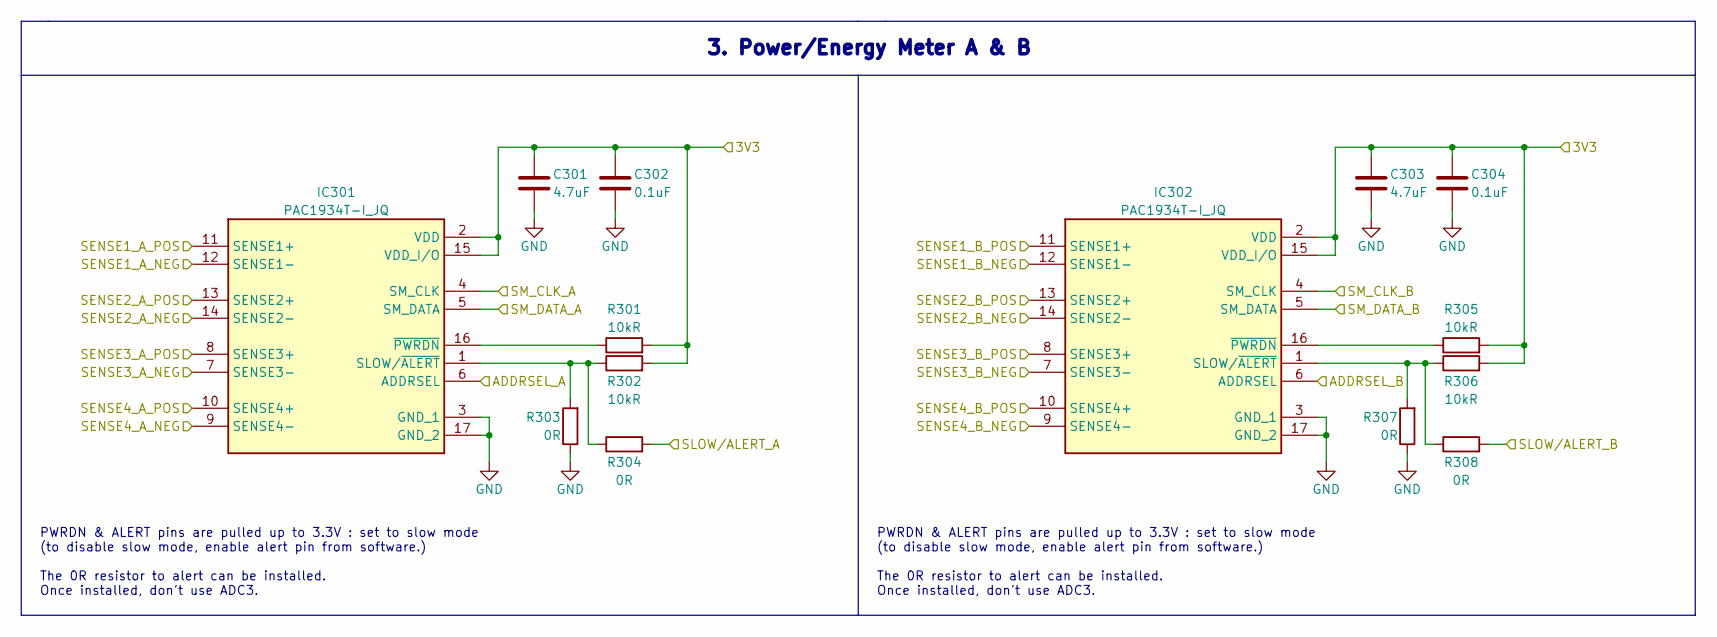
[picture p14: schematic PAC1934.kicad_sch, Solar Energy Manager]

Parts:
C301, C303: 4.7uF; C_0402_1005Metric
C302, C304: 0.1uF; C_0402_1005Metric
IC301, IC302: PAC1934T-I_JQ; QFN65P400X400X55-17N-D; Mouser Part Number 579-PAC1934JQ
R301, R302, R305, R306: 10kR; R_0402_1005Metric
R303, R304, R307, R308: 0R; R_0402_1005Metric

Connections:
/3v3_MCU: IC302.7 (SENSE3-); also elsewhere on the board
/3v3_Sec: C301.1, C302.1, C303.1, C304.1, IC301.2 (VDD), IC301.15 (VDD_I/O), IC302.2 (VDD), IC302.9 (SENSE4-), IC302.15 (VDD_I/O), R301.2, R302.2, R305.2, R306.2; also elsewhere on the board
/3v3_Vreg: IC302.8 (SENSE3+), IC302.10 (SENSE4+); also elsewhere on the board
/GPIO20/I2C0_SDA: IC301.5 (SM_DATA), IC302.5 (SM_DATA); also elsewhere on the board
/GPIO21/I2C0_SCL: IC301.4 (SM_CLK), IC302.4 (SM_CLK); also elsewhere on the board
/GPIO28/ADC2: R308.2; also elsewhere on the board
/GPIO29/ADC3: R304.2; also elsewhere on the board
/PAC1934/ADDRSEL_A: IC301.6 (ADDRSEL); also elsewhere on the board
/PAC1934/ADDRSEL_B: IC302.6 (ADDRSEL); also elsewhere on the board
/V_Loads: IC302.11 (SENSE1+); also elsewhere on the board
/s_1A_N: IC301.12 (SENSE1-); also elsewhere on the board
/s_1A_P: IC301.11 (SENSE1+); also elsewhere on the board
/s_1B_N: IC302.12 (SENSE1-); also elsewhere on the board
/s_2A_P: IC301.13 (SENSE2+); also elsewhere on the board
/s_2B_P: IC302.13 (SENSE2+); also elsewhere on the board
/s_3A_N: IC301.7 (SENSE3-); also elsewhere on the board
/s_3A_P: IC301.8 (SENSE3+); also elsewhere on the board
/s_4A_P: IC301.10 (SENSE4+); also elsewhere on the board
GND: C301.2, C302.2, C303.2, C304.2, IC301.3 (GND_1), IC301.9 (SENSE4-), IC301.14 (SENSE2-), IC301.17 (GND_2), IC302.3 (GND_1), IC302.14 (SENSE2-), IC302.17 (GND_2), R303.1, R307.1; also elsewhere on the board
unnamed: IC301.1 (SLOW/~ALERT), R302.1, R303.2, R304.1
unnamed: IC301.16 (~PWRDN), R301.1
unnamed: IC302.1 (SLOW/~ALERT), R306.1, R307.2, R308.1
unnamed: IC302.16 (~PWRDN), R305.1

Notes on the sheet:
PWRDN & ALERT pins are pulled up to 3.3V : set to slow mode (to disable slow mode, enable alert pin from software.) The 0R resistor to alert can be installed. Once installed, don't use ADC3.
3. Power/Energy Meter A & B

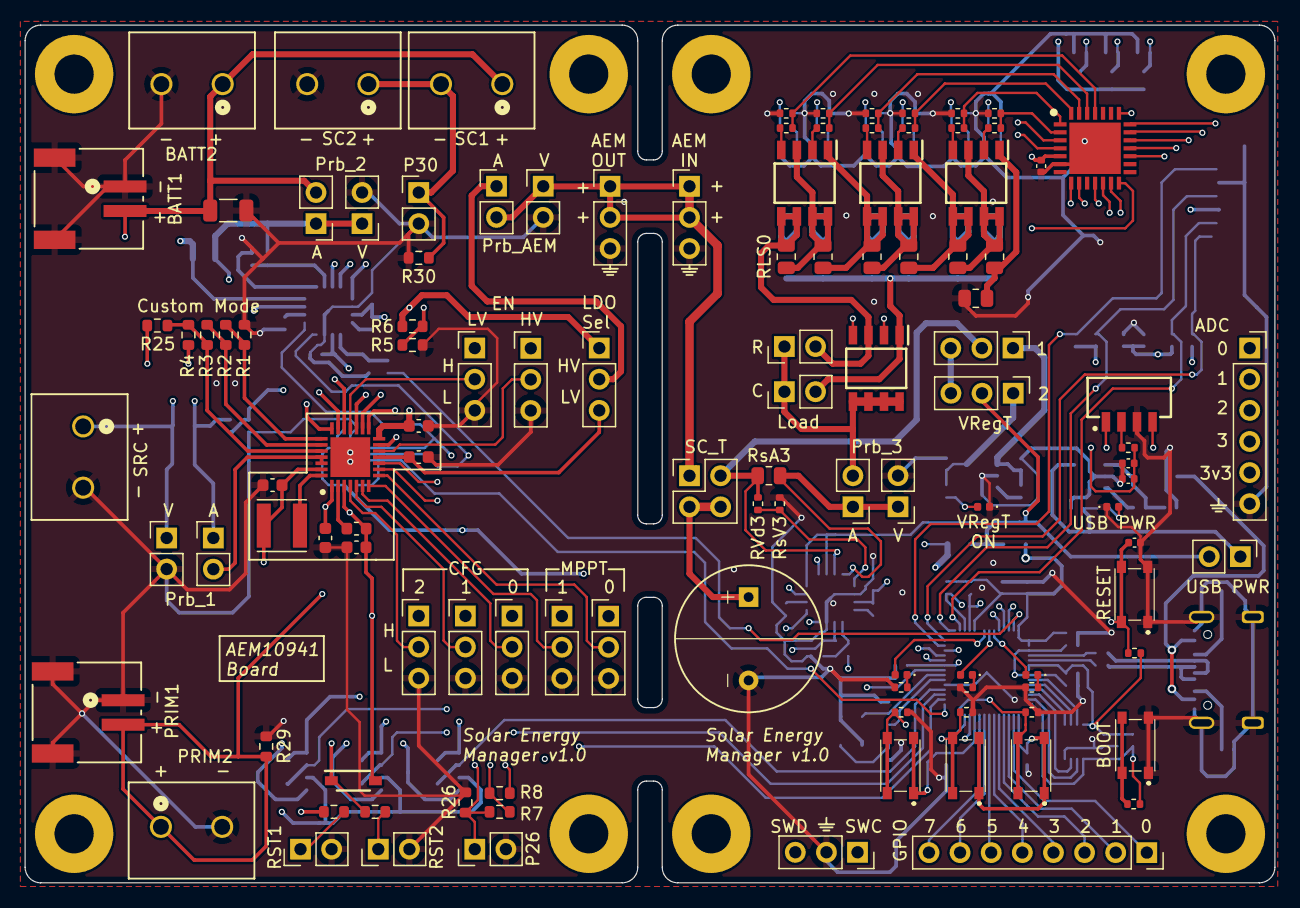
[picture p15: board SolarEnergyManager_v1.0.kicad_pcb from above]

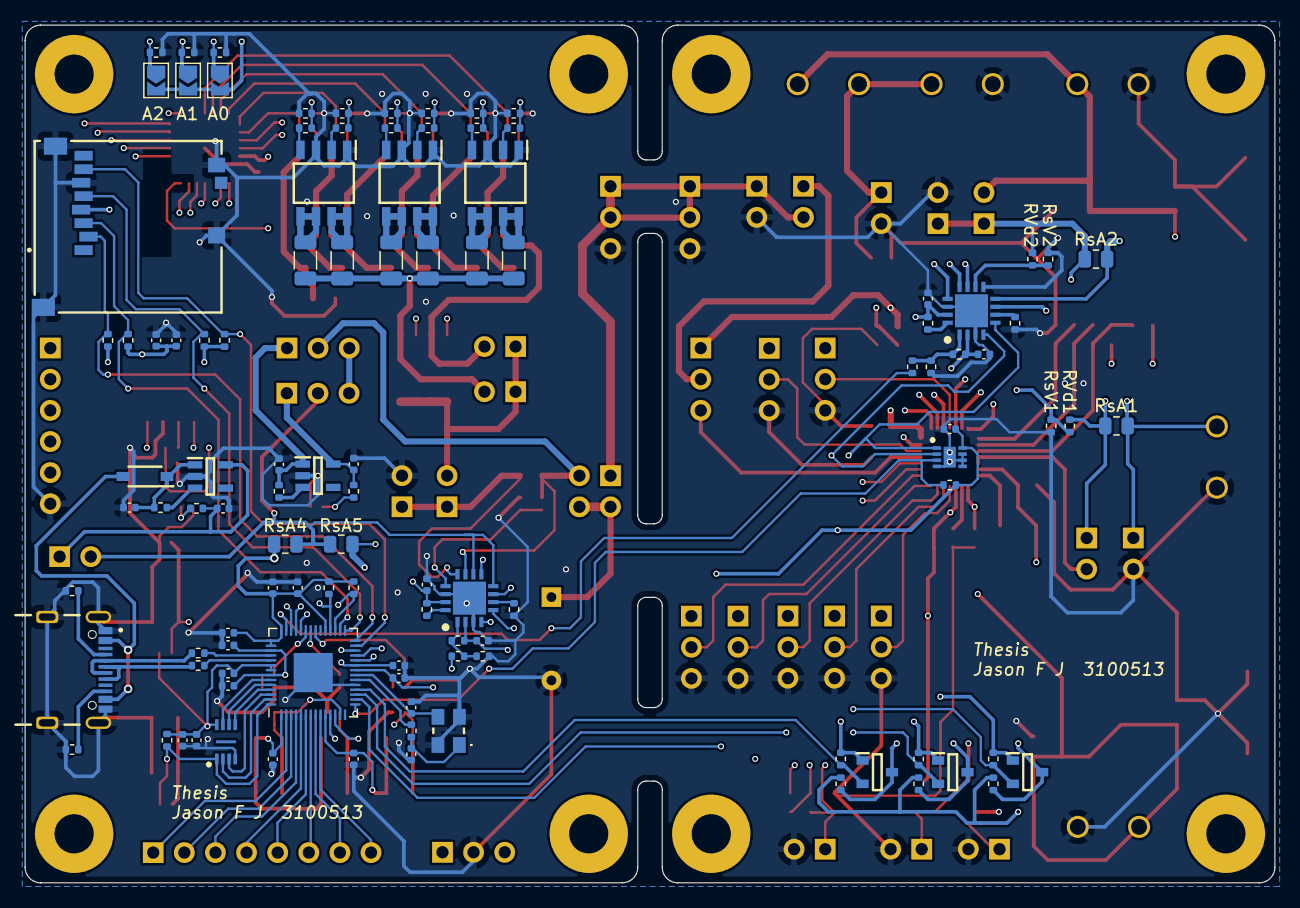
[picture p16: board SolarEnergyManager_v1.0.kicad_pcb from below]

Board: 4 copper layers, 102.0 x 70.0 mm, 229 parts (107 on the bottom side), 157 nets.
